sabas1080/Moonmakers_Cerebro/www/DIY EEG_files/FLZT2TPH3Z3C82W.LARGE.jpg

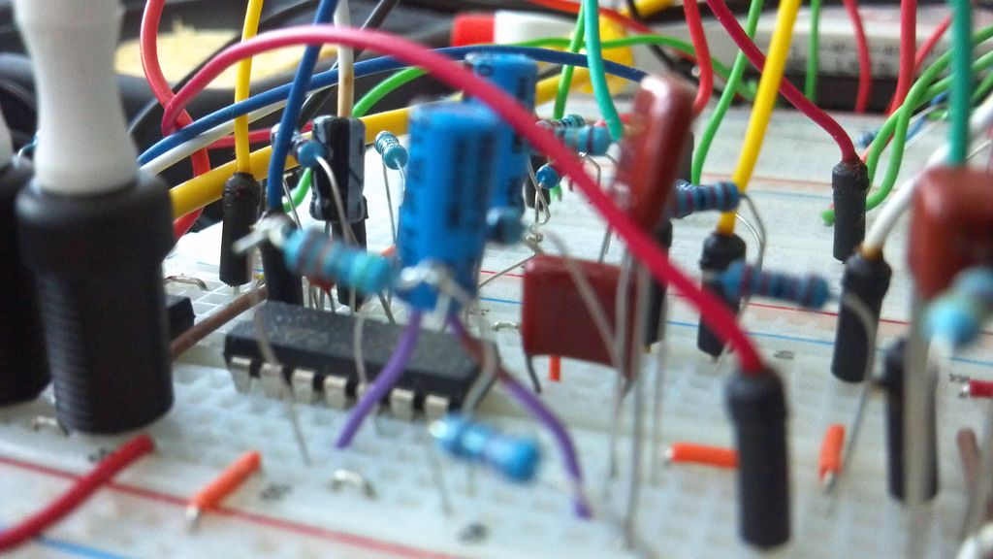
www/DIY EEG_files/FLZT2TPH3Z3C82W.LARGE.jpg
