sabas1080/Moonmakers_Cerebro/www/DIY EEG_files/FRONM3BH3QF1F05.LARGE.jpg

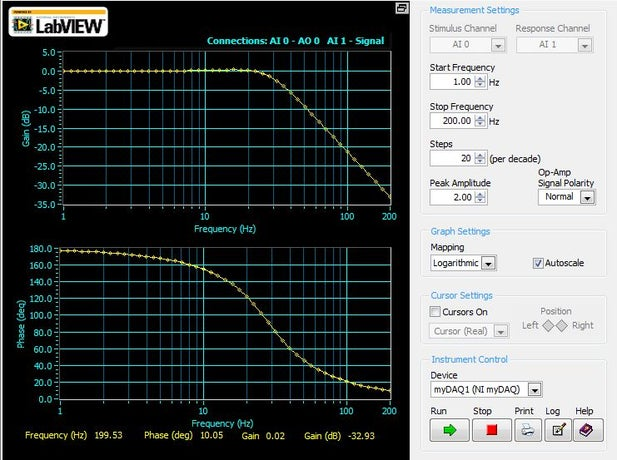
www/DIY EEG_files/FRONM3BH3QF1F05.LARGE.jpg
