sabas1080/Moonmakers_Cerebro/Docs/EEG/A5.pdf

## 4. Diseño y Construcción del EEG

### Juan Alejandro Alonso Toledo Herson Daniel Diaz Luna José Roberto Mendoza Pastor

13

### 4 DISEÑO Y CONSTRUCCIÓN DEL EEG

## 4. Diseño y Construcción del EEG

### Juan Alejandro Alonso Toledo Herson Daniel Diaz Luna José Roberto Mendoza Pastor

14

### 4.1 Etapa de amplificación

En general las señales generadas por el cuerpo humano tienen amplitudes muy pequeñas, comprendidas entre 1μV y 100 mV, aunado a ello existen grandes niveles de interferencia y ruido asociado a las mismas. Estas señales requieren ser amplificadas para hacerlas compatibles con una variedad de dispositivos, como equipos de cómputo, display y convertidores A/D, y de esta manera también se pueden manipular y trabajar a nuestra conveniencia, en este caso, un electroencefalógrafo. Para ello existen algunas recomendaciones que se deben tener en cuenta:

✓ El proceso fisiológico que será monitorizado no debe ser modificado de ninguna forma alguna por el amplificador.

✓ La señal medida no debe estar distorsionada.

✓ El amplificador debe ofrecer una señal de salida limpia, es decir sin interferencias.

✓ El amplificador debe ofrecer protección al paciente de cualquier shock eléctrico.

✓ El amplificador debe tener una protección contra daños causados por altos voltajes de entrada, ya que estos están presentes durante el uso de desfibriladores o algún otro elemento como un mal diseño de la instalación eléctrica, que no sea de grado médico o un mal sistema de tierras, es decir, que su impedancia esté por arriba de los 10 ohms.

El amplificador más recomendable para este fin es el amplificador de instrumentación debido a que cumple con todas las especificaciones ya comentadas.

## 4. Diseño y Construcción del EEG

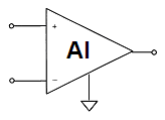
[picture p3: figure]

### Juan Alejandro Alonso Toledo Herson Daniel Diaz Luna José Roberto Mendoza Pastor

15

El amplificador de instrumentación ofrece el comportamiento más cercano a un amplificador ideal, la siguiente imagen muestra el símbolo del Amplificador de instrumentación (AI).

Fig. 4. Amplificador de instrumentación.

Los amplificadores de Instrumentación son amplificadores diferenciales que cumplen unos requisitos generales:

- Ganancia: seleccionable, estable, lineal.
- Entrada diferencial: con Razón de Rechazo en Modo Común (CMRR) alta.
- Error despreciable debido a las corrientes y tensiones de offset.
- Impedancia de entrada alta.
- Impedancia de salida baja

El circuito INA129 es el que mejor se adecua a nuestras necesidades ya que cuenta con un offset bajo, una corriente de bias mínima.

El circuito INA129 nos permite ajustar la amplificación a nuestra conveniencia simplemente modificando el valor de una resistencia llamada RG como se muestra en la figura 5, de tal modo que no es necesario calibrar resistencias:

## 4. Diseño y Construcción del EEG

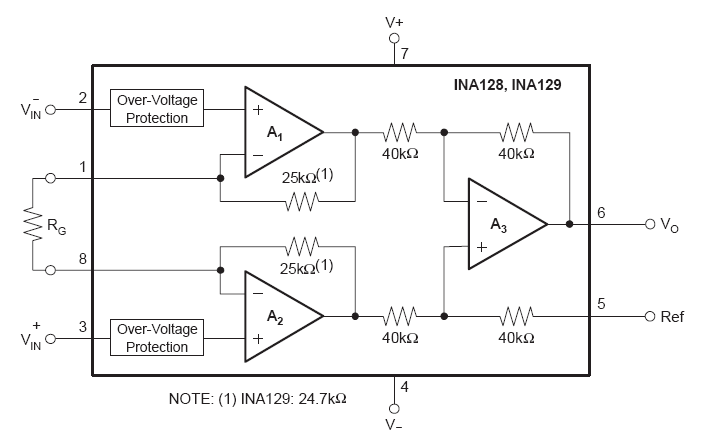
[picture p4: figure]

### Juan Alejandro Alonso Toledo Herson Daniel Diaz Luna José Roberto Mendoza Pastor

16

Fig. 5 INA129

En el diagrama se puede apreciar que el circuito integrado (CI) ya tiene un módulo de protección para sobre voltaje, antes de la amplificación.

Observar que RG permite variar la ganancia sin afectar la razón de rechazo en modo común, detallando que las resistencias ya están calibradas y nuestros acoplamientos establecidos por el INA129, la ganancia se obtiene con la siguiente expresión:

## 4. Diseño y Construcción del EEG

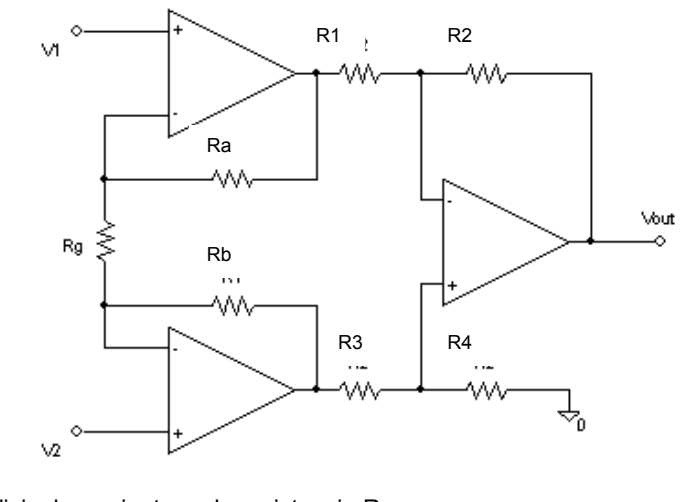
[picture p5: figure]
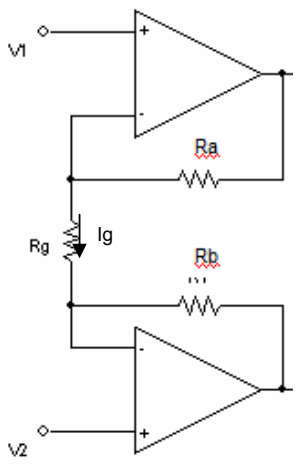
[picture p6: figure]

### Juan Alejandro Alonso Toledo Herson Daniel Diaz Luna José Roberto Mendoza Pastor

17

Análisis matemático.

Amplificador de Instrumentación: INA129

Se realiza el análisis de corriente en la resistencia Rg.

Vo

Rg

V V

Ig | 1 - 2 = | ;

### Ra Rg Rb

### Va Vb Ig

+ +

- =

Vb

Va

## 4. Diseño y Construcción del EEG

### Juan Alejandro Alonso Toledo Herson Daniel Diaz Luna José Roberto Mendoza Pastor

18

Para cumplir con una alta Razón de Rechazo en Modo Común, hacemos que Ra=Rb=R, entonces se igualan las ecuaciones.

Rg

### V1 -V2 = R Rb Va Vb

+

2
( | ) Rg V V
Vo Va Vb | R Rg 1 | 2 2 | - = | - | = | +
( | ) 1 | 2
2 1 | V V
Rg
R Vo | - ÷
÷
ø

ö
ç

ç
è

æ = +

Etapa diferencial

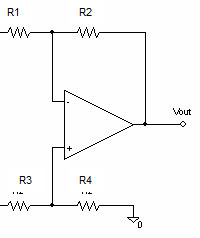
[picture p7: figure]

Obtenemos Vout, aplicando los valores al amplificador diferencial.

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
Vout
+

+
= - +

Esta es la expresión general. Para una condición ideal en la que R1=R3 y R2=R4, se tiene:

### ( ) Va Vb

R

R
Vout = - | -

1

2

## 4. Diseño y Construcción del EEG

### Juan Alejandro Alonso Toledo Herson Daniel Diaz Luna José Roberto Mendoza Pastor

19

Cómo Vo=Va-Vb, entonces, el caso general:

( | ) 1 | 2

1

2 1 2 V V
Rg

R
R

R
Vout | - ÷

÷
ø

ö
ç

ç
è

æ = - +

La ganancia:

÷

÷
ø

ö
ç

ç
è

æ = +
Rg

R
R

R
G 1 2

1

2

Para calcular el CMRR se sabe que:

CMRR=

### Gcm

Gd

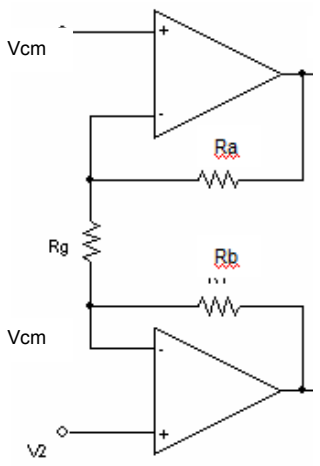
[picture p8: figure]
Vcm

Se deduce que la tensión en V1 y V2 es la misma por lo que:

CMRR= | 1 | 2

2

1 | 2 | * . . | Gd CMR

### Gcm

### Gd x Gd Gcm

Gd = | =

## 4. Diseño y Construcción del EEG

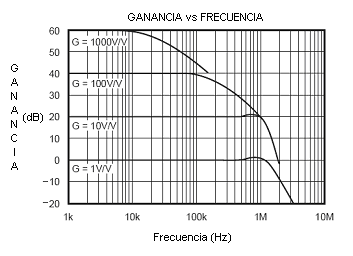
[picture p9: figure]

### Juan Alejandro Alonso Toledo Herson Daniel Diaz Luna José Roberto Mendoza Pastor

20

La etapa de amplificación está basada como anteriormente se mencionó en el circuito integrado INA129, ya que éste solo nos provee de una ganancia máxima igual a 1,000 se manejarán tres etapas adicionales de amplificación, las cuales serán amplificadores inversores, cabe señalar que estos amplificadores serán TL062, para lograr una ganancia igual a 1,000,000 con la finalidad de ver las señales neuronales en una escala de 0 a 0.5 volts, y así mismo esto servirá para poder realizar la comunicación con la computadora, ya que el muestreo de las señales tiene que estar en el orden de los volts para poder ser monitorizados y muestreadas por la computadora; de tal forma que las ganancias de las etapas quedarán de la siguiente manera:

- Amplificador de instrumentación: Para este amplificador se manejará una ganancia de 100, para que este no trabaje a su máxima potencia y vaya a introducir ruido en la señal a causa de la frecuencia que se maneja.

Fig. 6 Comportamiento del INA129

## 4. Diseño y Construcción del EEG

### Juan Alejandro Alonso Toledo Herson Daniel Diaz Luna José Roberto Mendoza Pastor

21

Se calculó con la siguiente expresión:

100 = 1+

Por lo tanto el valor de la resistencia | para el primer amplificador es de RG=
498.98Ω
- Post amplificadores inversores: En esta etapa se manejarán dos ganancias una de 100 para la segunda etapa y otra de 10 para la tercera y cuarta etapas, la finalidad de agregar una cuarta etapa es que la señal no quede invertida y se calculó de la siguiente manera:

Vout = - Vin

- Así que para la segunda etapa, con ganancia de 100, se utilizaron resistencias Rf=10 kΩ y Rin=100 Ω, lo que brinda una ganancia de 100.
- Y finalmente para la tercera y cuarta etapa, la ganancia de 10, se utilizaron resistencias Rf=1 kΩ y Rin=100 Ω, lo que nos brinda una ganancia de 10.

Ya teniendo las ganancias se realiza el cálculo de la ganancia total que es 100x100x10x10= 1,000,000.

49.4KΩ
RG

G = 1+

49.4KΩ
RG

RG = 49.4KΩ
99

Rf
Rin

## 4. Diseño y Construcción del EEG

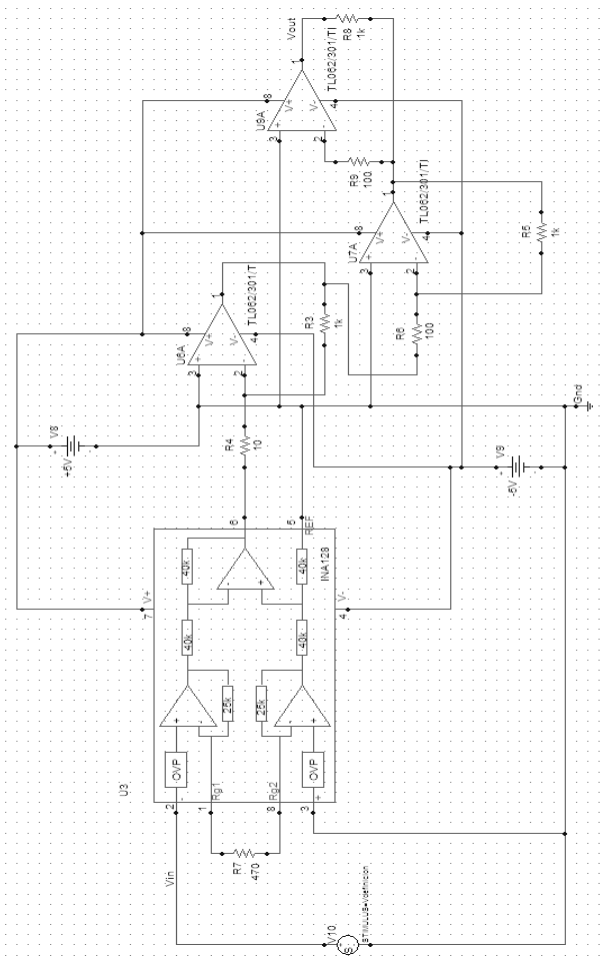
[picture p10: figure]

### Juan Alejandro Alonso Toledo Herson Daniel Diaz Luna José Roberto Mendoza Pastor

22

## 4. Diseño y Construcción del EEG

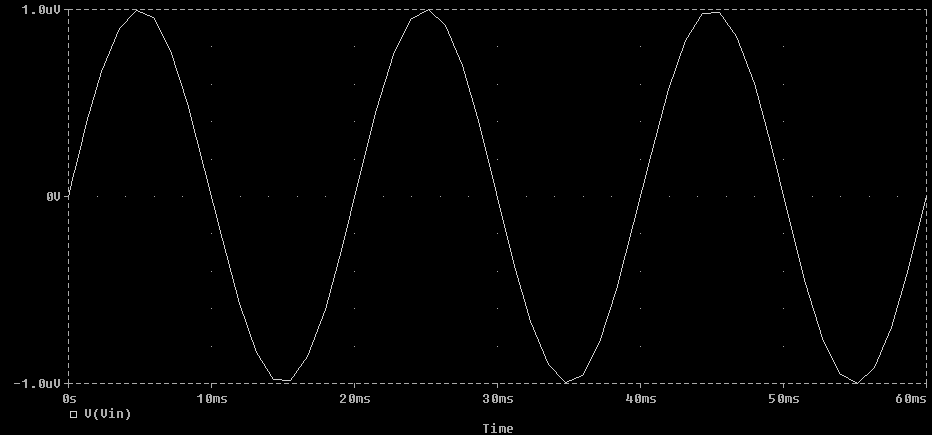
[picture p11: figure]
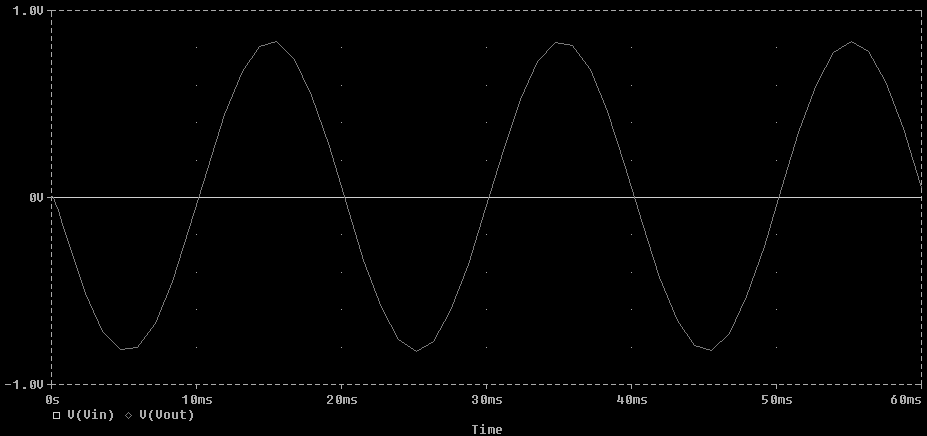
[picture p12: figure]

### Juan Alejandro Alonso Toledo Herson Daniel Diaz Luna José Roberto Mendoza Pastor

23

Fig. 7 Diseño de la etapa de amplificación Una vez calculado, la simulación arroja lo siguiente:

Simulación

Fig. 8 Señal de entrada (Vin) = 2μVPP@50Hz

Fig. 9 Señal de salida (Vout) ≈1.6VPP@50Hz

## 4. Diseño y Construcción del EEG

### Juan Alejandro Alonso Toledo Herson Daniel Diaz Luna José Roberto Mendoza Pastor

24

### 4.2 Etapa de filtrado

Los filtros son de los elementos más utilizados en equipos eléctricos. Su función es separar y dejar pasar las señales presentes en ciertas bandas de frecuencia y bloquear las señales de otras bandas que no sean deseables. En general en un filtro eléctrico deben pasar, sin perdidas, la energía en algunas frecuencias e introducir atenuación en otras.

Los electroencefalógrafos empleados en las clínicas y hospitales, se diseñan dentro de las frecuencias de importancia clínica, comprendidas entre los 0.1 y los 50 Hz; por lo tanto, para el modelo clínico, la frecuencia superior deberá estar limitada mediante un filtro pasa bajas, con una frecuencia de corte en los 50 Hz, sin embargo el diseño cuenta con una frecuencia de corte de 120 Hz para permitir a los neurólogos el estudio de la banda gamma. Para esto se utiliza el apoyo del amplificador, el cual proporciona impedancia de entrada alta por lo tanto corriente de entrada baja e impedancia de salida baja.

Para esta aplicación se han elegido filtros activos, ya que los filtros pasivos RLC presentan grandes inconvenientes prácticos para las bajas frecuencias. Esto se debe a que cuanto más baja es la frecuencia, más grandes, y deficientes son los inductores.

Otras ventajas de los filtros activos son:

1. Tamaño reducido.- Debido al empleo de Amplificadores Operacionales (AO) integrados, se reducen las dimensiones del circuito, siendo los capacitores (de mayor tamaño a menor frecuencia) los que generalmente fijan el tamaño del dispositivo.
2. Independencia entre etapas.- Permite la realización de filtros de cualquier orden, simplemente conectando en cascada etapas de primer y segundo orden; además cada etapa puede ser ajustada por separado.
3. Ganancia en la banda de paso.- Además de proveer rechazo para las frecuencias, no deseadas, amplifica las señales cuya frecuencia se encuentra en la banda de paso del filtro.
4. Costo reducido.- El costo del filtro lo determina el amplificador operacional.

## 4. Diseño y Construcción del EEG

### Juan Alejandro Alonso Toledo Herson Daniel Diaz Luna José Roberto Mendoza Pastor

25

En el manejo de señales electroencefalográficas se tienen señales no periódicas y que hacen irreconocible la señal que verdaderamente se quiere estudiar, a esto se le conoce como ruido. Al amplificar es posible que se magnifiquen las señales biológicas a medida que se aumenta la amplificación. Esto quiere decir que al utilizar una máxima amplificación, señales demasiado pequeñas podrían ser detectadas. Cuando la señal biológica se encuentra en el nivel de una señal ruidosa o en el mismo nivel, ambas señales serán amplificadas por igual, perdiéndose el valor de la señal de interés. El nivel de ruido en la electroencefalografía, es un potencial generado por los amplificadores y también puede ser externo, y no debe exceder de 2µV; este potencial se origina en la primera etapa de amplificación.

En el tratamiento de señales se debe tomar en cuenta que existen algunas frecuencias que no son deseadas. Se requiere eliminar señales que tengan valores de frecuencia que pudieran interferir y obstruir la exacta observación de las señales electroencefalográficas. Para éste propósito después de la etapa de amplificación utilizamos una etapa de filtrado en la que se empleó un filtro paso bajas y un filtro supresor de banda, esto por las características de las señales a tratar.

## 4. Diseño y Construcción del EEG

### Juan Alejandro Alonso Toledo Herson Daniel Diaz Luna José Roberto Mendoza Pastor

26

Filtro paso bajas
Amplitud
Banda | Banda de
de paso | rechazo
fc | frecuencia

La respuesta en amplitud es
÷
ø

ö ç
è
æ = | Vi
Vo f dB | 10 ( ) 20log

Filtro Notch
A

Banda de
rechazo

f
fL | fo | fH

fo en función de Q, y la ganancia de banda de paso Ao, la respuesta del filtro notch en amplitud dB:

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
2 2 2

2

10
1

1

### ( ) 20log

### Qfo

### fin

fo

### fin

fo

### fin

### AdB Ao dB

Donde

2

L | H f | f fo | + = | ; | 2
4 ² | 2 BW | BW | fo f L
- | + | + = | ; f H = f L + BW

L H fo = f f , este ofrece un mejor promedio geométrico.

## 4. Diseño y Construcción del EEG

### Juan Alejandro Alonso Toledo Herson Daniel Diaz Luna José Roberto Mendoza Pastor

27

BW

fo Q = | ; | H | L BW = f - f

Por tanto:

| | H | L L H
H | L | f | f

f f
f | f
fo Q | - = - =

Filtro Butterworth

La respuesta en frecuencia generalmente:

n

PB

fc

### fin

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
= | ó
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
æ = | - | +

n

PB | fc

### fin AdB A dB

2

### ( ) 10log10 1

fin – frecuencia de entrada fc - frecuencia de corte
APB - ganancia de voltaje
n - orden del filtro

Filtros de 2º orden.

Función de transferencia:

2 1 1 2

( ) ( )

### a s a s

### P s H s

+ + =

P(s) depende del tipo de respuesta.

2

1 2
o

a

ω = ;
o

a
ω

2ζ 1 =

Factor de calidad:

2ζ

1 Q = | ; por tanto | Q o
a
ω

1 1 =

## 4. Diseño y Construcción del EEG

### Juan Alejandro Alonso Toledo Herson Daniel Diaz Luna José Roberto Mendoza Pastor

28

Para un filtro paso bajas:

2 | 2

2
( )
s o
Q

o
s

### o H s

ω

ω

ω
+ +

=

Tomamos en cuenta que utiliza la estructura:

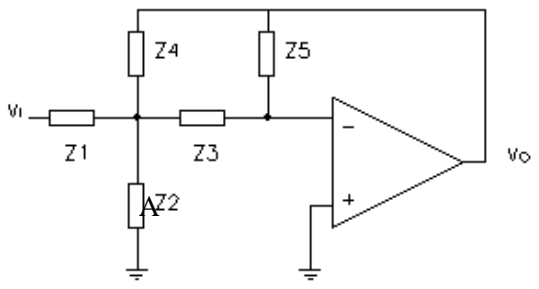
[picture p13: figure]

Analizamos V’ en el punto A:

5 Vo = IZ ;
Z5

### Vo I =

5

3
3 ' | Z

Z

### V = -IZ = -Vo

Aplicamos Kirchhoff en el Punto A:

0 ' 0 | ' | '
1 | 2 | 4 | 5
+ | = - + - + -
Z

Vo
Z

### Vo V

Z

V
Z

### Vi V

Despejamos Vi

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
+ | + | + ÷

÷
ø

ö
ç

ç
è
æ = - | +
1 | 4 | 5 | 1 | 2 | 4
1 | 1 | 1 ' 1 | 1
Z | Z | Z

V
Z Z

Vo
Z

Vi

## 4. Diseño y Construcción del EEG

### Juan Alejandro Alonso Toledo Herson Daniel Diaz Luna José Roberto Mendoza Pastor

29

Usando V’

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
æ = - | + | + | + | + | + ÷
÷
ø

ö
ç

ç
è
æ - | + | + ÷
÷
ø

ö
ç

ç
è
æ = - | +
5 | 1 | 2 | 4

3

5 | 1 | 2 | 4 | 4 | 5

3

1 | 4 | 5
1 | 1 | 1 | 1 | 1 | 1 | 1 | 1 | 1 | 1
Z | Z | Z | Z

Z
| | | | | Z | Z

Vo
Z Z | Z | Z

Z
Vo
Z Z

Vo
Z

Vi

Así la función de transferencia:

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
+ | + | + | + | +

= -

5 | 1 | 2 | 4

3

4 5

1
1 | 1 | 1 | 1 | 1

1

Z | Z | Z | Z

Z
Z Z

Z
Vi

Vo

Haciendo Z1, Z4 y Z3 resistencias y Z2, Z5 capacitores:

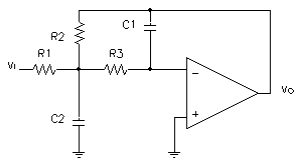
[picture p14: figure]

Tomando en cuenta que

2

2

1
sC

Z = y

5

5

1
sC

Z =

( | ) 1 2 3 2
2
3 1
1

2 3 1
2 1

1

2

2

2
1
1 | 3 | 1
2

1
1 1 | 1 | 1

1

### R C s C C R R

R

### R R C s R C

R

R

R

sC
R

### sC R sC

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
+ | + | +

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
+ | + | + | +

= -

Para una ganancia unitaria R2=R1:

( | ) | 3 2 1 2
2
1 | 2 | 3 1 | 2

1
Vi | sC R | R | s R R C C

Vo
+ | + | + = -
Cómo | 1 2

2
2

### 1 R C C

o = ω
si hacemos C1=C2

## 4. Diseño y Construcción del EEG

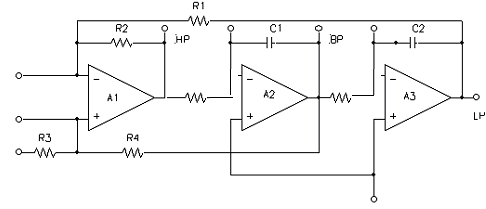
[picture p15: figure]

### Juan Alejandro Alonso Toledo Herson Daniel Diaz Luna José Roberto Mendoza Pastor

30

2 2
2

### 1 R Co

o = ω

### ; Obteniendo R

Co

R
ω

1 =

Filtro Universal
Al conectar 3 amplificadores Operacionales, se puede tener un paso bajas de orden 2, paso altas y paso banda, con gran factor de calidad Q.

A1 es un Amplificador diferencial, A2 y A3 integradores.

En la etapa de filtrado se empleo el circuito integrado UAF42 de Texas Instruments, un filtro universal activo que dentro de las ventajas que brinda es que puede ser configurado de distintas formas para poder convertirlo en un filtro paso bajas, paso altas y paso bandas. Su configuración se basa en un amplificador inversor y dos integradores. En este circuito los integradores incluyen capacitores de 1000pF. Este tipo de arquitectura resuelve un problema que se presenta al diseñar filtros activos, que es obtener una tolerancia ajustada, y tener capacitores de baja pérdida.

Para este circuito

### RC fc 2π

1 = | ; | 3 RA = (3Q -1)R

Este filtro permite valores de Q muy altos, con buena estabilidad.

## 4. Diseño y Construcción del EEG

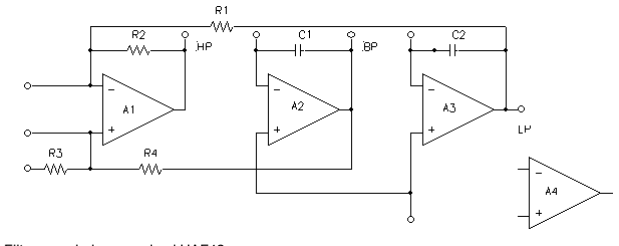
[picture p16: figure]
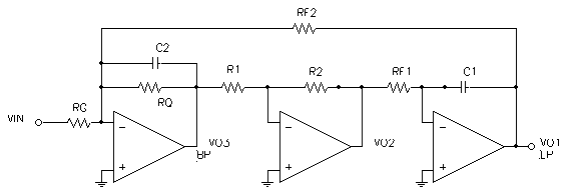
[picture p17: figure]

### Juan Alejandro Alonso Toledo Herson Daniel Diaz Luna José Roberto Mendoza Pastor

31

Filtro Universal: UAF42

Filtro paso bajas usando el UAF42

1 1

2
1 | sRF C
Vo Vo = - | ;

1 1

2

### 2 sRF C

R
Vo = -

1 1 1

2

### 1 3 sRF R C R Vo = Vo

Vo3 depende de las entradas, por tanto:

## 4. Diseño y Construcción del EEG

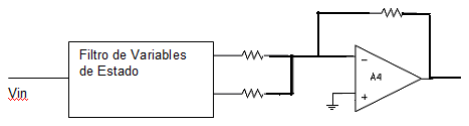
[picture p18: figure]

### Juan Alejandro Alonso Toledo Herson Daniel Diaz Luna José Roberto Mendoza Pastor

32

( | ) | ( | ) 1

1
| 1

1

1

1

1

1

2 | 2 | 2 | 2

2

2

2

2

3

+ - + = -

+

+
= - | RF sC RQ

### RQ Vo RG sC RQ

### RQ Vi

RF

### sC RQ

### sC RQ

Vo
RG

### sC RQ

### sC RQ

### Vo Vi

Sustituyendo Vo1:

( | ) 1 | ( | ) 1 1 1 1 | 2 | 2

2
3
2

3

+ - + = - | RF sC RQ

RQ

### sRF R C

R
Vo

### RG sC RQ

RQ Vo | Vi
( | ) 1 | ( | ) 1

1

2 | 2 | 1 1 1 | 2

2
3

+ ú = -
û

ù ê
ë

é
+

+

### RG sC RQ

### RQ Vi RF sC RQ sRF R C

### RQR Vo

La función de transferencia es:

( | )
( | ) | 1 | 2 1 1
| | | 2
2
2 | 1 | 2 1 1

2

3 | 2
1
1

1

1

### sRF RF C R

### RQR sC RQ

RG

RQ

sC RQ | sRF RF R C RQR
RG | sC RQ RQ

Vi

Vo
+ +

= -
+

+

+ = -

1 | 2 1 2 1
| 2

2

2

3 | 2

### RF RF C C R

R

### C RQ

S
s

### RGC

s

Vi

Vo
+ +

= -

Una característica del filtro universal es que se puede sumar el paso bajas y el paso altas, lo que nos da un filtro Notch de variables de estado. Para esto se requiere un amplificador Operacional adicional y 3 resistencias iguales.

Notch Out

## 4. Diseño y Construcción del EEG

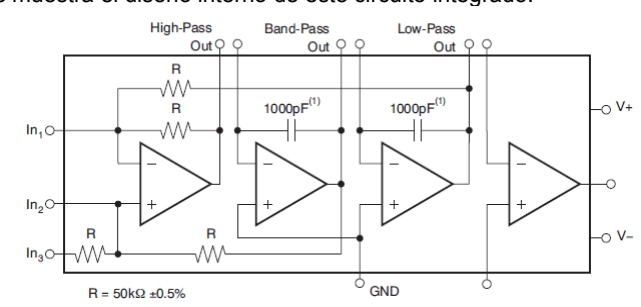
[picture p19: figure]

### Juan Alejandro Alonso Toledo Herson Daniel Diaz Luna José Roberto Mendoza Pastor

33

A continuación se muestra el diseño interno de este circuito integrado:

Fig. 10 Diseño interno del UAF42

La topología clásica de este circuito forma un filtro de tiempo continuo. Libre de anomalías y ruido conmutado asociado a filtros con capacitores conmutados.

Diseño de la etapa de filtrado

Para poder obtener una configuración exacta y con los valores precisos se utilizó un software compatible con DOS (sistemas operativos de disco), este software mediante los valores deseados de frecuencia que se quiere obtener y la tolerancia requerida brinda la configuración y los valores exactos de resistencias y capacitores externos para poder generar los filtros utilizados.

El software utilizado, proviene de una serie de programas de diseño llamado FilterPro creados por Burr-Brown. Utilizando el llamado FILTER42, que es específicamente usado para configuraciones del UAF42. El programa es sencillo, es una guía paso a paso y realiza el cálculo exacto de los valores de los componentes. Para un filtro Butterworth, se tiene una atenuación de 3dB en la frecuencia de corte. El circuito más simple consiste en un solo subcircuito de dos polos como se muestra en la figura

Fig. 11 Subcircuito 1

## 4. Diseño y Construcción del EEG

### Juan Alejandro Alonso Toledo Herson Daniel Diaz Luna José Roberto Mendoza Pastor

34

Otros filtros más complejos son armados en cascada. Incluso filtros de otros órdenes son implementados completamente con secciones de dos polos con el UAF42 y no se requieren capacitares externos.

Fig. 12 Filtros en cascada

En este caso la etapa de filtrado se arma en cascada, primero la señal pasa por el filtro pasa bajas y después por el filtro de rechazo de banda mediante herramientas que se muestran más adelante.

Por las características mencionadas antes, se utilizó un filtro Butterworth que entrega mejores resultados que las otras familias, maximiza la magnitud de aplanamiento en la respuesta en un paso banda, un buen comportamiento completo, una respuesta de pulso mejor que el Chebyshev y una razón de atenuación mejor que el Bessel.

El programa provee subcircuitos de par-polo, estos consisten en una configuración de estado variable. Dos parámetros deben ser configurados para el par-polo son el filtro Q y la frecuencia natural fo. Para esto se tienen dos resistencias, Rf1 y Rf2 para configurar fo. Y una resistencia externa RQ es usualmente utilizada para configurar Q.

## 4. Diseño y Construcción del EEG

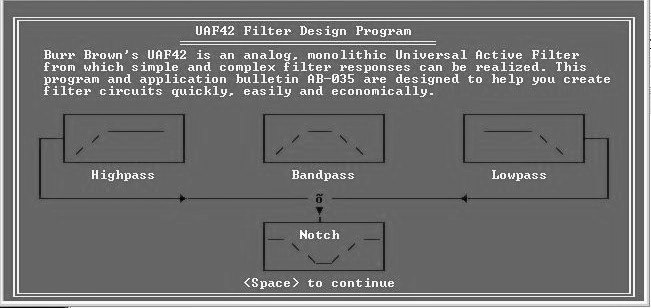
[picture p20: figure]
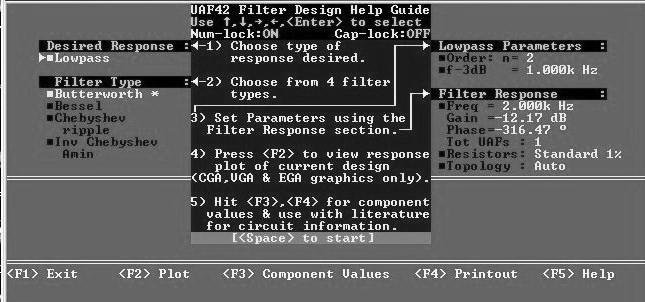
[picture p21: figure]

### Juan Alejandro Alonso Toledo Herson Daniel Diaz Luna José Roberto Mendoza Pastor

35

El programa:

Fig. 13 Pantalla inicial del programa

En la ventana se muestra el tipo de filtros que puede diseñar el programa, a continuación para poder entrar al menú de configuración, el cual nos presenta una pequeña guía.

Fig. 14 Menú del programa

El menú Desire Response. Permite elegir entre cuatro tipo de filtros: Paso bajas, paso altas, paso banda y rechazo de banda.

El menú Filter Type. Nos da a elegir entre varios grupos de filtros.

## 4. Diseño y Construcción del EEG

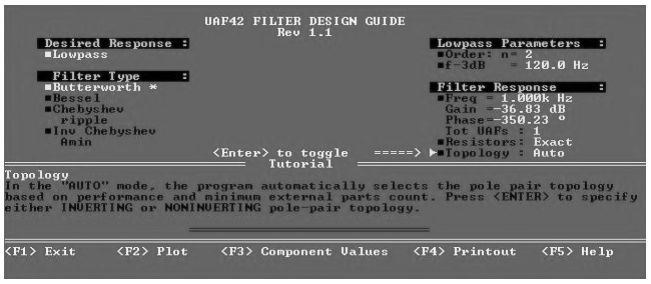
[picture p22: figure]
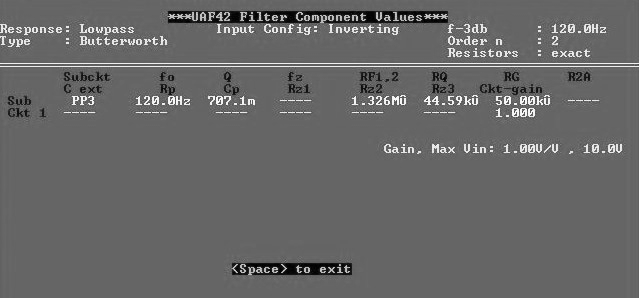
[picture p23: figure]

### Juan Alejandro Alonso Toledo Herson Daniel Diaz Luna José Roberto Mendoza Pastor

36

El menú Parameters. Esta sección permite configurar los parámetros de orden del filtro n (de 2 a 10), y la frecuencia del filtro.

El menú Filter Response. Para poder configurar la respuesta en frecuencia.
En este caso se eligió un filtro paso bajas tipo Butterworth, y se configuran los valores de frecuencia y respuesta deseados.

Fig. 15 Elección de la topología La topología a utilizar se obtiene automáticamente mediante el programa y se busca en la hoja de especificaciones, son los llamados par-polo (PP). En la parte inferior muestra un menú, ahora se elige la opción Component Values, para obtener los valores exactos.

Fig. 16 Valores de los componentes a usar

## 4. Diseño y Construcción del EEG

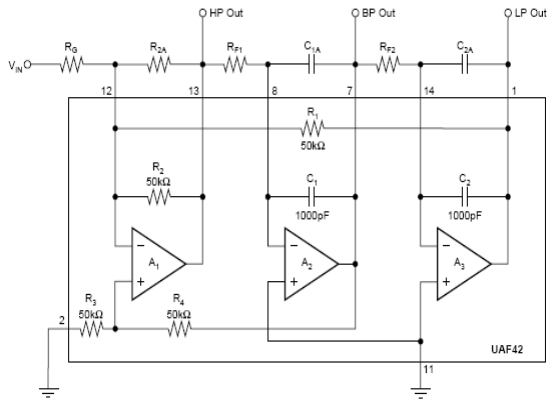
[picture p24: figure]

### Juan Alejandro Alonso Toledo Herson Daniel Diaz Luna José Roberto Mendoza Pastor

37

La ventana muestra una serie de valores de frecuencia natural (fo) en este caso de 120 Hz, los valores de RF1 y RF2, así como de RQ y Rg, los cuales proporcionan una ganancia unitaria. También indica que PP utilizar para el filtro paso bajas y en este caso es el PP3 el cual se muestra a continuación.

Fig. 17 Configuración del filtro paso bajas

## 4. Diseño y Construcción del EEG

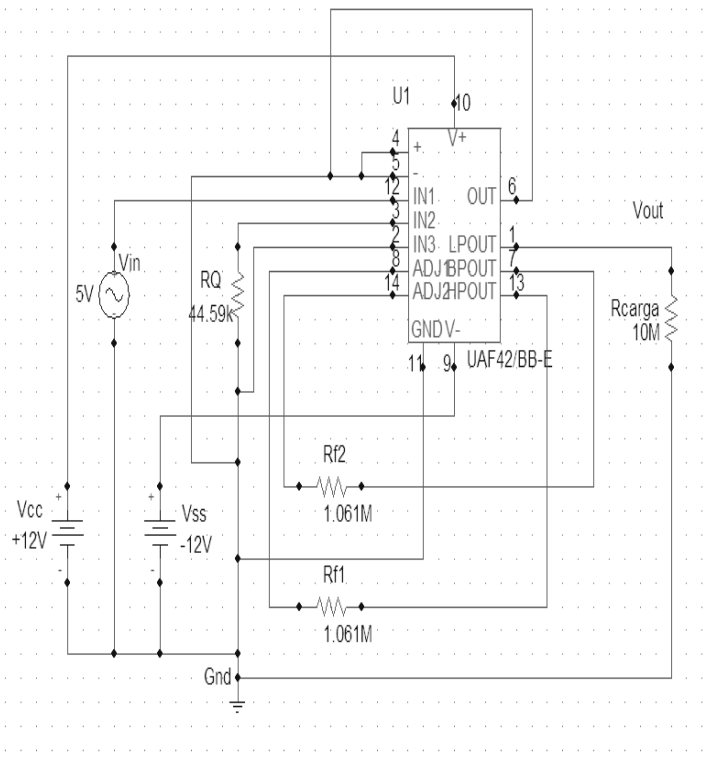
[picture p25: figure]

### Juan Alejandro Alonso Toledo Herson Daniel Diaz Luna José Roberto Mendoza Pastor

38

Fig. 18 El diseño utilizado para el filtro de paso bajas

## 4. Diseño y Construcción del EEG

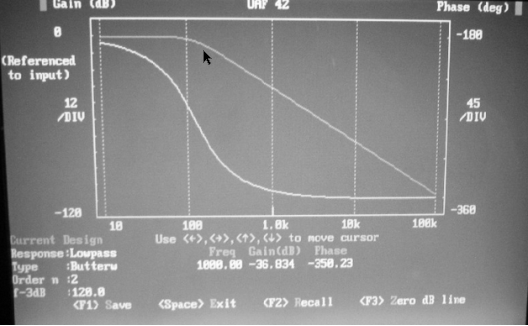
[picture p26: figure]

### Juan Alejandro Alonso Toledo Herson Daniel Diaz Luna José Roberto Mendoza Pastor

39

Mediante este software es posible visualizar una gráfica de fase contra frecuencia. Esto para comparar entre filtros y ver como se comportará en la implementación. Para este caso se observa así, donde la línea señalada por la flecha negra muestra el comportamiento del filtro.

Fig. 19 Gráfica del comportamiento del filtro

Para el filtro rechazo de banda se realiza lo mismo, solo que debemos elegir el filtro Notch. Configurar el orden, que en este caso es de 4º orden, la frecuencia de corte de 60Hz y un ancho de banda de 10 Hz. Como se muestra en la figura 20.

## 4. Diseño y Construcción del EEG

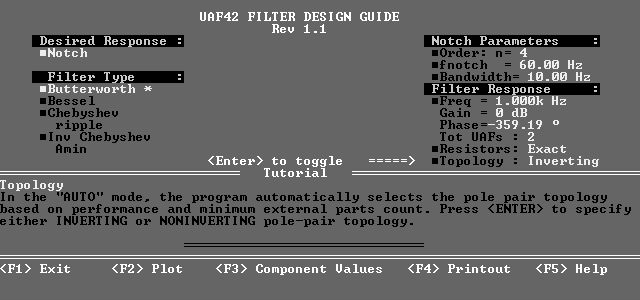
[picture p27: figure]
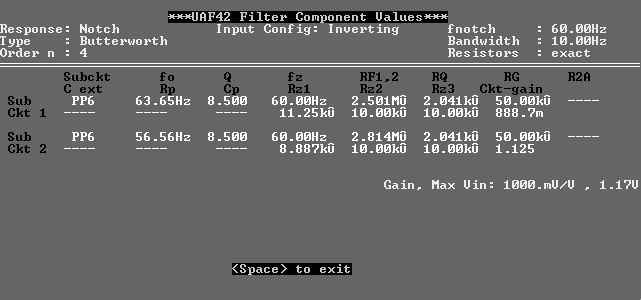
[picture p28: figure]

### Juan Alejandro Alonso Toledo Herson Daniel Diaz Luna José Roberto Mendoza Pastor

40

Fig. 20 Elección de la topología

El siguiente paso es conocer los valores y el tipo de topología a utilizar (PP). Mediante la opción Component Values.

Fig. 21 Valores de los componentes a usar

El cual proporciona una serie de valores para las resistencias y el subcircuito PP a utilizar, en este caso es el PP6, esta configuración suma las salidas de paso bajas y paso altas utilizando un amplificador operacional auxiliar A4 dentro del UAF42.

## 4. Diseño y Construcción del EEG

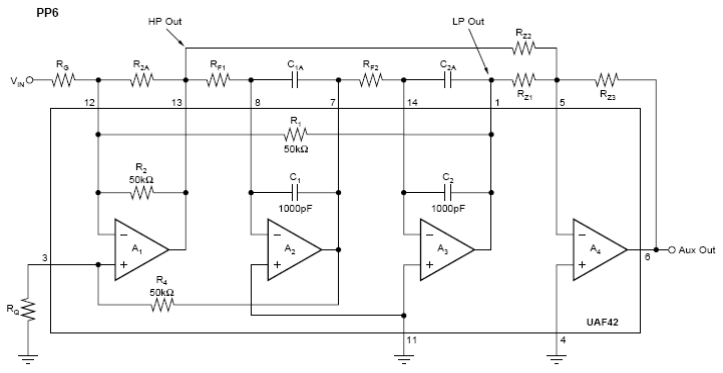
[picture p29: figure]
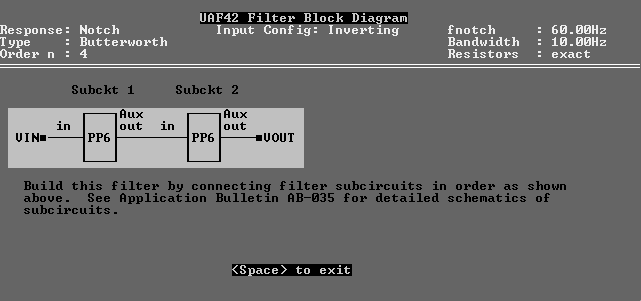
[picture p30: figure]

### Juan Alejandro Alonso Toledo Herson Daniel Diaz Luna José Roberto Mendoza Pastor

41

Fig. 22 Configuración del subcircuito para el filtro rechazo de banda.

Para lograr el filtro rechazo de banda, se requiere colocar dos subcircuitos PP6 en cascada como se muestra en la figura 23.

Fig. 23 Diagrama de bloques del filtro rechazo de banda.

Quedando el diseño del filtro supresor de banda de la siguiente manera, utilizando dos UAF42 conectados en cascada.

## 4. Diseño y Construcción del EEG

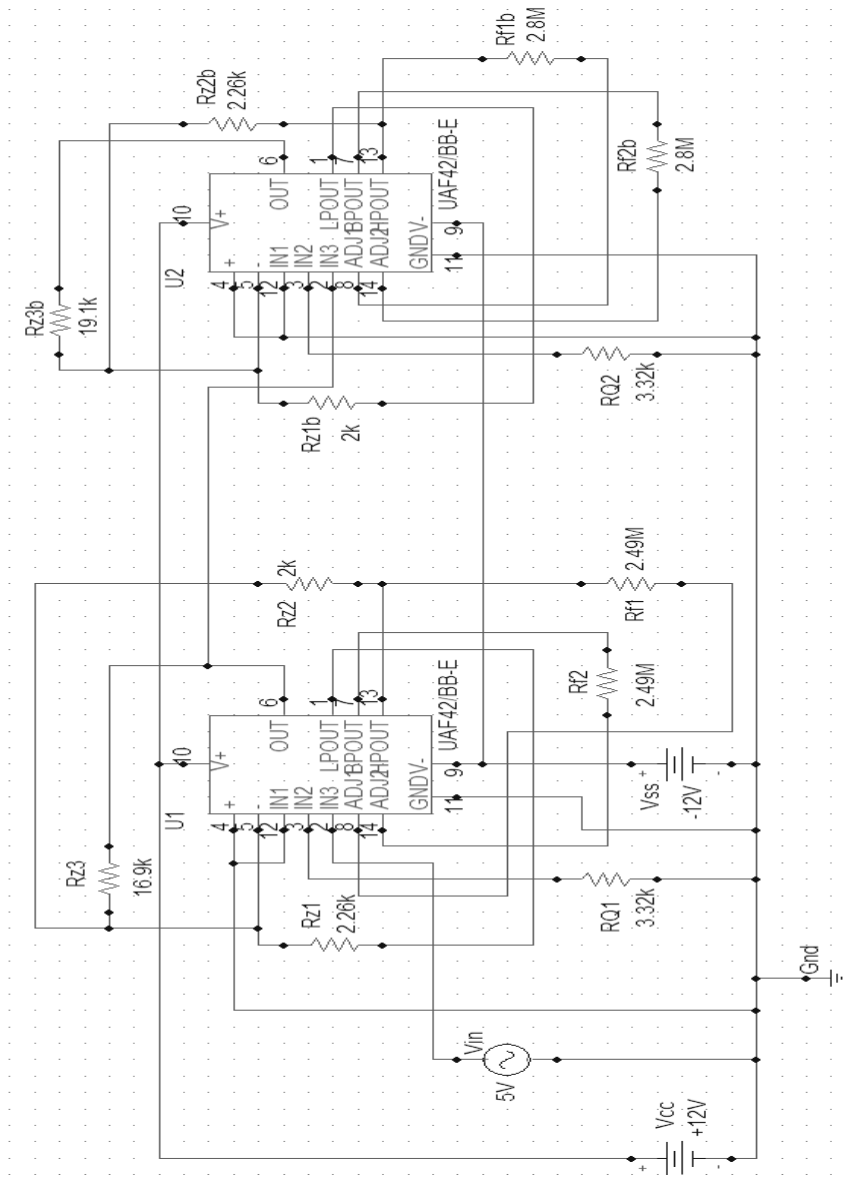
[picture p31: figure]

### Juan Alejandro Alonso Toledo Herson Daniel Diaz Luna José Roberto Mendoza Pastor

42

Fig. 24 Filtro rechazo de banda

## 4. Diseño y Construcción del EEG

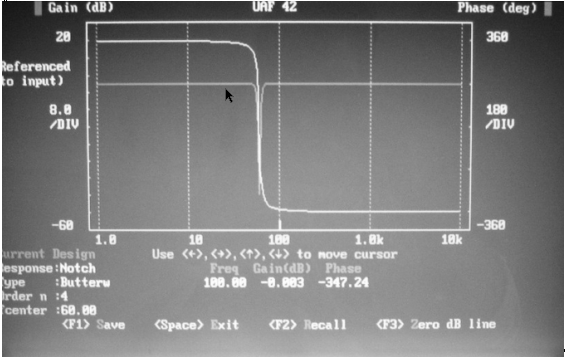
[picture p32: figure]

### Juan Alejandro Alonso Toledo Herson Daniel Diaz Luna José Roberto Mendoza Pastor

43

También usando la utilidad Plot se obtuvo la gráfica de cómo se comportará nuestro filtro rechazo de banda.

La línea señalada con la flecha negra indica el comportamiento del filtro el cual tiene su mayor atenuación al llegar a los 60Hz.

Fig. 25 Gráfica del comportamiento del filtro

## 4. Diseño y Construcción del EEG

### Juan Alejandro Alonso Toledo Herson Daniel Diaz Luna José Roberto Mendoza Pastor

44

### 4.3 Etapa de compensación de offset

En las aplicaciones de amplificadores de corriente continua, ciertas características eléctricas del amplificador operacional pueden provocar errores en el voltaje de salida, para ello es posible implementar un circuito divisor con resistencias aceptablemente complejo que pueda imprimir un pequeño voltaje variable para compensar los efectos de la desviación de voltaje en la entrada y la desviación de corriente. Sin embargo, los componentes extra son más costosos y grandes de lo necesario.

Generalmente uno de los principales problemas que se tiene en el registro de un EEG es el corrimiento de la línea de base producido por causas tan variadas como; movimientos involuntarios del paciente, polarización de los electrodos por un mal contacto, fluctuaciones de temperatura, etc.; lo que dificulta tener una buena calidad en la señal registrada, por lo que contar con un sistema de compensación de offset es sumamente necesario.

El efecto de la tensión de offset de entrada sólo es influida por la ganancia de la etapa, y esta es una característica funcional que está establecida en las especificaciones del diseño. Hay dos formas de atenuar el efecto del offset de tensión:

1. Seleccionando el amplificador operacional adecuado: Los fabricantes reducen el offset de tensión de entrada de los amplificadores operacionales utilizando técnicas especiales de diseño del amplificador. Actualmente se ofrecen amplificadores operacionales con offset muy bajos.
2. Compensando el offset mediante un circuito interno o externo: En aplicaciones de precisión, se debe compensar el efecto combinado del offset de tensión de entrada, de la intensidad de polarización y de la intensidad de offset.

Cuando un amplificador no posee un mecanismo de compensación de offset interno, se puede añadir algunos elementos externos que realicen su cancelación. En estos circuitos es muy importante tener en cuenta lo pequeño del valor del offset que se está compensando. Para este proyecto se utilizó un modelo de corrector de offset a la salida de la etapa de filtrado, con la finalidad de garantizar una señal limpia, libre de voltaje de offset, ya que debido a la naturaleza de

## 4. Diseño y Construcción del EEG

### Juan Alejandro Alonso Toledo Herson Daniel Diaz Luna José Roberto Mendoza Pastor

45

nuestra ganancia fácilmente es posible amplificar ruido de 60 Hz si no están bien calibradas nuestras etapas de filtrado.
Integrador (Compensador de Offset)

Vo

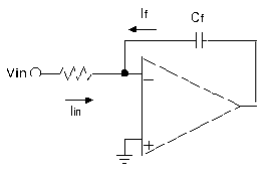
[picture p33: figure]

### Vin t

RC

## ΔVo = - • 1

R

Vin Iin = ;
t
Vo If | Cf Δ
Δ = - | ; | Vin t

### RCf

ΔVo = - | Δ 1
= | Þ
R

X
A | c
CL | ganancia de lazo cerrado ; | fRCf
ACl | 2π

1 =

En este caso se utilizó el TL062, utilizando la configuración de un amplificador integrador, en el cual se observó que el elemento que lleva a cabo la realimentación en el integrador es el condensador C1. Por consiguiente, la corriente constante I, en C1 da lugar a una rampa lineal de tensión. La tensión de salida es, por tanto, la integral de la corriente de entrada (que proviene de la salida de la etapa de filtrado), que es forzada a cargar C1 por el lazo de realimentación, obteniendo una señal de salida sin corrimiento, desviación de voltaje, la configuración se muestra en la siguiente imagen:

## 4. Diseño y Construcción del EEG

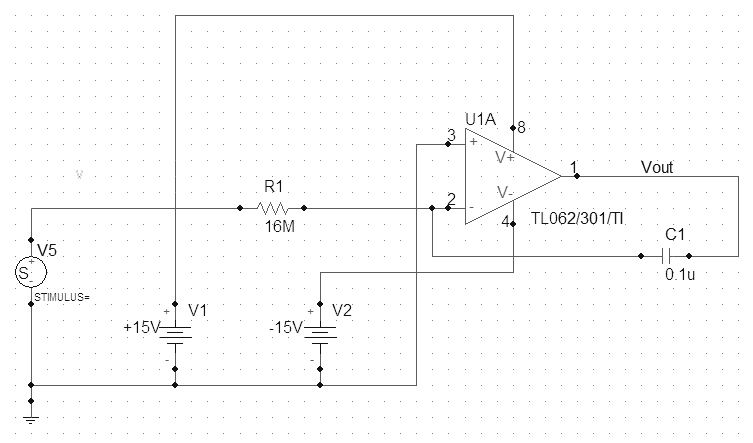
[picture p34: figure]

### Juan Alejandro Alonso Toledo Herson Daniel Diaz Luna José Roberto Mendoza Pastor

46

Fig. 26 Compensador de offset

Tomando como base un capacitor de 0.1μF y una frecuencia de trabajo de 0.01Hz se calculó la resistencia necesaria del modo siguiente:

f =

R =

R = | = 16MΩ

1
2пRC

f2пC

1

0.01(2п)0.1μ

1

## 4. Diseño y Construcción del EEG

### Juan Alejandro Alonso Toledo Herson Daniel Diaz Luna José Roberto Mendoza Pastor

47

Con esta última etapa termina el módulo del acondicionamiento de la señal, que es la parte elemental del diseño e implementación del electroencefalógrafo que se ha construido.

### 4.4 Etapa de aislamiento

Independientemente de lo simple o complejo que sea un dispositivo médico de medición, este debe ser seguro, la seguridad debe ser el primer objetivo del diseño. Cuando se habla de seguridad se refiere principalmente a la seguridad eléctrica, debido a que los daños que pueden ser causados al cuerpo humano son severos, por ejemplo se sabe que una corriente, de 60Hz, con una intensidad de 10μA que fluye a través del corazón causará un daño permanente al mismo o incluso la muerte. Por lo cual se deben tener en consideración las bases para diseñar y construir un sistema médico eléctricamente seguro.

Efectos de la corriente eléctrica en el cuerpo humano

Las corrientes eléctricas producen tres tipos de efectos en el cuerpo humano: alteraciones funcionales por estimulación de células excitables (tejidos nervioso y muscular); destrucción irreversible de tejidos por efecto Joule; y quemaduras químicas. Los dos primeros son los más graves generalmente y no dependen del origen de las corrientes. Las quemaduras químicas se producen al reaccionar con la piel los electrólitos liberados por el paso de una corriente continua o de muy baja frecuencia. Para evitarlas hay que limitar su valor a 10μA como máximo.
En los tejidos excitables se ha encontrado experimentalmente que hay una relación entre la intensidad y la duración de la corriente necesarias para que se produzca la estimulación, y que varía según los tejidos. Cuando se presentan estímulos cortos, hace falta más corriente, y por ello al aumentar la frecuencia es mayor la amplitud necesaria para lograr la estimulación. Las peores frecuencias resultan ser precisamente las de 50-60Hz. Por otra parte, por debajo de una intensidad mínima (denominada reobase) no hay estimulación aunque esté aplicada durante mucho tiempo. Por último, cabe destacar que el parámetro de interés no es la tensión sino la intensidad de corriente, aunque, como el área de contacto puede ser muy variable, los límites se dan como valores de intensidad de corriente.

El nivel mínimo en el que una persona puede detectar conscientemente si hay o no un estímulo presente (cosquilleo), define el umbral de percepción. Depende sobre todo de la zona del cuerpo y del área de contacto, del sexo y de la frecuencia. Por ejemplo, para frecuencias de 50-60Hz,

## 4. Diseño y Construcción del EEG

### Juan Alejandro Alonso Toledo Herson Daniel Diaz Luna José Roberto Mendoza Pastor

48

cuando un hombre se encuentra tocando un conductor con la mano, el valor medio es de 1.1mA. Si solo se apoya ligeramente el dedo, es de 0.36mA, mientras que deslizándolo es de 10μA. Con la lengua el valor mínimo es de 4μA y el valor medio 43μA. Para las mujeres, los valores al tocar o tocar con la mano son del 67% de los del hombre. A frecuencias menores y mayores, el umbral aumenta. El valor medio para hombres, tocando con la mano, es de 5.2mA en continua y de 12mA a 10kHz. Cuando el nivel de la corriente aumenta se alcanza un punto en el que la sensación es irritante si se va repitiendo.
Con niveles de corriente mayores se producen contracciones musculares involuntarias. Si el estímulo ocurre de forma inesperada, produce un reflejo muscular involuntario.

Para corrientes de 60Hz, el valor medio de la corriente necesaria en hombres es de 16mA. En si no es un peligro, pero, si se prolonga, puede producir asfixia. Para corrientes de 23mA, aparecen dificultades respiratorias en el 50% de los hombres.

La frecuencia de la corriente influye en los niveles necesarios para tener los efectos anteriores. En la siguiente figura se presentan las gráficas en función de la frecuencia. Para la corriente continua, la intensidad Ic.c. que produce el mismo efecto que una corriente alterna (50-60Hz) Ic.a., para tiempos entre 10ms y 10s, es:

I c.c = I c.c log t

Cuando la corriente es mayor, si el camino de la corriente incluye al corazón hay peligro de fibrilación auricular o ventricular, con la consiguiente pérdida de eficiencia en el bombeo de sangre. A diferencia de los efectos mencionados anteriormente, la fibrilación no desaparece al cesar el estímulo, y solo se puede detener mediante una descarga intensa. En el caso de un contacto directo con el miocardio, una intensidad de 100μA puede ser fatal.

Para corrientes mayores de 100mA se puede producir tetanización muscular (parálisis respiratoria si quedan afectados los músculos del tórax), y quemaduras externas si la intensidad de corriente es suficiente, con independencia de su frecuencia en este caso.

## 4. Diseño y Construcción del EEG

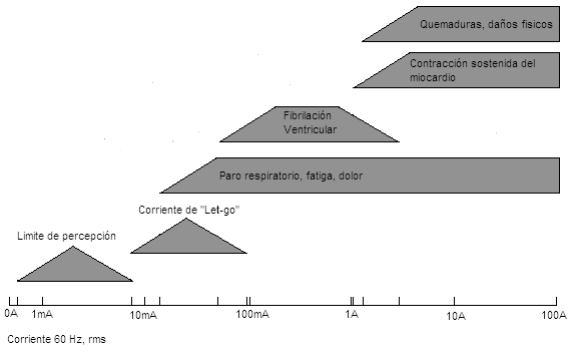
[picture p35: figure]

### Juan Alejandro Alonso Toledo Herson Daniel Diaz Luna José Roberto Mendoza Pastor

49

Fig. 27 Efectos de la corriente que fluye a través de un paciente.

También es importante para minimizar riesgos tomarse el tiempo necesario para instruir a los miembros del equipo clínico en el uso correcto del dispositivo y los posibles riesgos que pudieran existir en caso de negligencia o mal uso del mismo; recordar que si algo sale mal es el personal clínico quien deberá salvarle la vida al paciente.

### 4.5 Fuente de alimentación

Tomando en cuenta lo ya mencionado sobre seguridad del paciente una alternativa muy conveniente para alimentar los equipos médicos es el uso de baterías. Esto no solo asegura de manera inherente que las corrientes de fuga sean mínimas, también hace el equipo altamente portátil y permite tener un equipo muy seguro debido a que se asegura que el paciente y el equipo quedan totalmente aislados de la línea eléctrica sin importar que la instalación sea grado médico. Para este caso el uso de dos baterías recargables fue suficiente, lo que resulta muy conveniente ya que el costo es reducido aún teniendo que adquirir el cargador para dichas baterías.

## 4. Diseño y Construcción del EEG

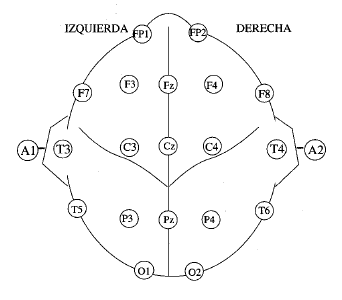
[picture p36: figure]

### Juan Alejandro Alonso Toledo Herson Daniel Diaz Luna José Roberto Mendoza Pastor

50

### 4.6 Multiplexión

Una vez que se tiene el módulo completo de amplificación construido y funcionando, se procede al diseño de la etapa de multiplexión, esta etapa tiene gran importancia, ya que es la que nos va a permitir visualizar los 32 canales. Primero se procede al análisis de los elementos, debido a que la tarjeta de la computadora es estéreo, contamos con dos canales de entrada, por lo cual se utilizarán dos módulos de amplificación, una vez mencionada esta consideración, continuamos con el diseño de la multiplexión.

En un estudio estándar de electroencefalografía, se cuenta con un total de 21 electrodos y se colocan de la manera en que muestra la figura 28:

Fig. 28 Posición de los eléctrodos.

Con esta colocación se tiene la posibilidad de hacer un registro longitudinal o un registro transversal.

## 4. Diseño y Construcción del EEG

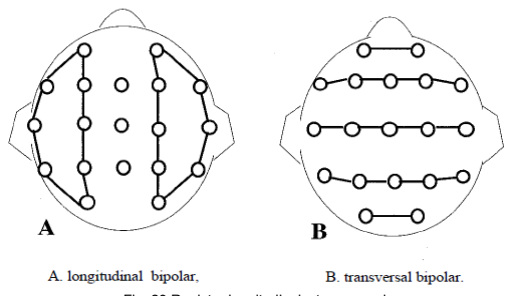
[picture p37: figure]

### Juan Alejandro Alonso Toledo Herson Daniel Diaz Luna José Roberto Mendoza Pastor

51

Fig. 29 Registro longitudinal y transversal.

En la siguiente tabla se muestran las comparaciones que se hacen para cada canal dependiendo el tipo de registro:

Canal | Longitudinal | Transversal | Canal | Longitudinal | Transversal
1 | FP1 - F3 | FP1 – FP2 | 9 | FP1 – F7 | Cz – C4
2 | F3 - C3 | F7 – F3 | 10 | F7 – T3 | C4 – T4
3 | C3 – P3 | F3 – Fz | 11 | T3 – T5 | T4 – A2
4 | P3 – O1 | Fz – F4 | 12 | T5 – O1 | T5 – P3
5 | FP2 – F4 | F4 – F8 | 13 | FP2 – F8 | P3 – Fz
6 | F4 – C4 | A1 – T3 | 14 | F8 – T4 | Pz – P4
7 | C4 – P4 | T3 – C3 | 15 | T4 – T6 | P4 – T6
8 | P4 – O2 | C3 – Cz | 16 | T4 – O2 | O1 – O2

Como se observa son 16 canales por cada tipo de registro, esto da la pauta a que el equipo diseñado registre esos 32 canales de manera que se obtienen en un solo estudio sin mayor complicación, para lograr esto con solo dos módulos de amplificación se requiere de una multiplexión.

Un multiplexor es un selector de datos, es decir, que permite la entrada de datos desde varias fuentes, pero solo permite la salida a una de ellas, dicha salida es controlada digitalmente, manipulando las llamadas entradas de selección. A continuación se muestra el diagrama funcional de un multiplexor:

## 4. Diseño y Construcción del EEG

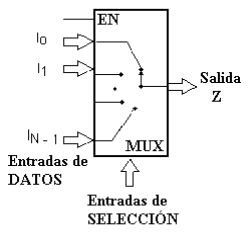
[picture p38: figure]

### Juan Alejandro Alonso Toledo Herson Daniel Diaz Luna José Roberto Mendoza Pastor

52

Fig. 30 Diagrama funcional de un multiplexor.

Las flechas de entrada se representan de esa manera para mostrar que no se refiere solo a una línea de entrada sino que pueden ser varias líneas, la línea de entrada marcada con “EN” se refiere al habilitador, la cual se coloca en un potencial cero para que el multiplexor funcione.

Para el control del multiplexor, que como ya se mencionó se hace de manera digital, se empleo una memoria EEPROM, la cual tiene los datos de control de cada multiplexor, de esta manera cada uno de los multiplexores sabe qué señal es la que debe de mandar a la salida, a su vez esta memoria es controlada por un contador binario de 4 bits, esto con la finalidad de que el control de cada multiplexor se lleve a cabo de manera autónoma, y por último se implementó mediante un temporizador una señal de reloj, requerida por el contador, con frecuencia de 1Hz para que cada señal sea muestreada por periodos de 1 segundo.

Para la implementación se eligieron los multiplexores de la serie CD405X, estos son multiplexores que manejan tanto señales digitales así como analógicas de hasta 20Vp-p, tiene un tiempo de propagación de 20ns y un manejo de ancho de banda de hasta 10MHz, tomando en cuenta estas características principales se adaptan fácilmente a las necesidades de nuestro diseño.

Si bien ya mencionamos las características de los multiplexores, cabe señalar que no fueron explotados al 100%, ya que las señales de entrada que se manejan son de una magnitud muy pequeña, este mismo multiplexor nos permite manejarlas sin distorsión considerable ni ruido, también el rango que maneja para las señales analógicas permite tener una libertad total en las señales como se muestra en la siguiente gráfica, cabe señalar que la respuesta en el rango es prácticamente lineal.

## 4. Diseño y Construcción del EEG

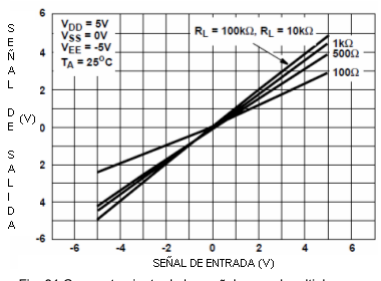
[picture p39: figure]

### Juan Alejandro Alonso Toledo Herson Daniel Diaz Luna José Roberto Mendoza Pastor

53

Fig. 31 Comportamiento de las señales en el multiplexor.

## 4. Diseño y Construcción del EEG

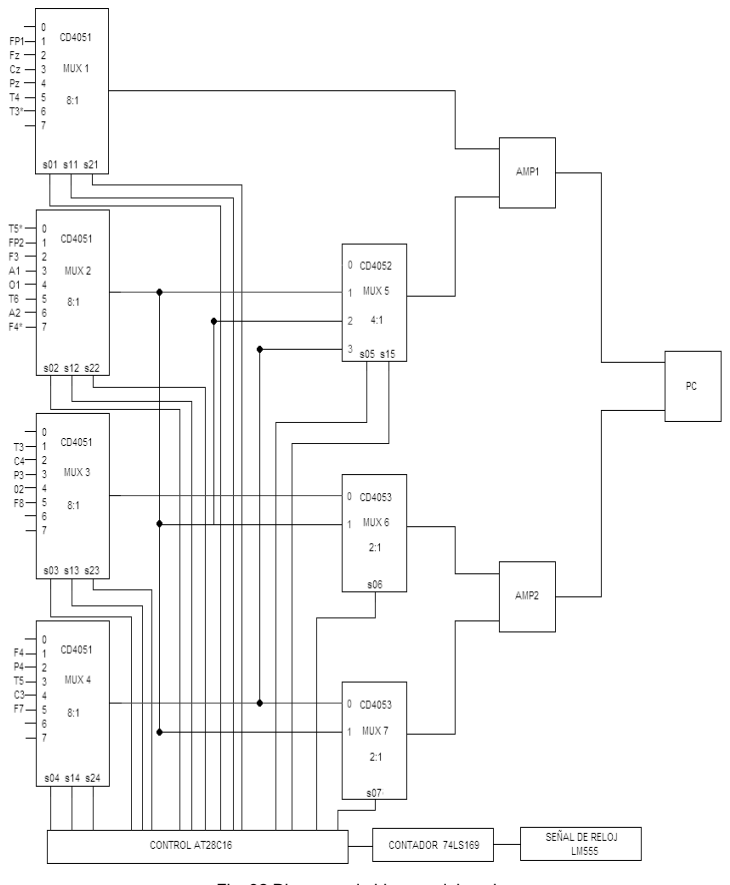
[picture p40: figure]

### Juan Alejandro Alonso Toledo Herson Daniel Diaz Luna José Roberto Mendoza Pastor

54

Fig. 32 Diagrama de bloques del equipo.

## 4. Diseño y Construcción del EEG

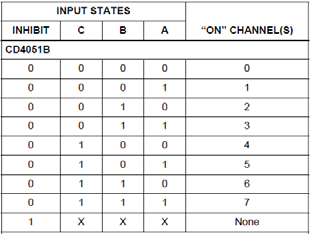
[picture p41: figure]
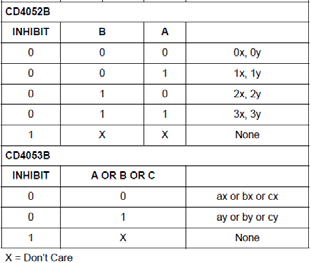
[picture p42: figure]

### Juan Alejandro Alonso Toledo Herson Daniel Diaz Luna José Roberto Mendoza Pastor

55

Como se observa se utilizan tres diferentes multiplexores, el CD4051, el CD4052 y el CD4053.

El CD4051 es un multiplexor 8:1, se utilizan 4 de este tipo, en el se conectan todos los electrodos, estos son los que llevarán el control principal de cada uno de ellos, según el canal que vaya a ser muestreado será la señal que manden a la salida, a la salida de ellos encontramos que la salida del MUX1 va directamente hacia una entrada del amplificador 1(AMP1), sin embargo las salidas de los MUX2, MUX3 y MUX4 se dirigen a otro grupo de multiplexores, en el caso del MUX5 se trata de un CD4052 que es un multiplexor 4:1, mientras que los MUX6 y MUX7 son CD4053 que son multiplexores 2:1, esta disposición fue necesaria para manejar toda la combinación que se debe hacer de las señales de los electrodos para registrar los 32 canales, como se observa dependiendo del canal que se vaya a muestrear, serán enviados los datos a la entrada de control de cada uno de los multiplexores por la memoria para que de esta manera las señales sean enviadas a cada una de las entradas de los amplificadores, y a la salida de estos últimos a cada uno de los canales de la computadora y de esta manera sean visualizados.

A continuación se presenta la tabla de verdad de cada uno de los multiplexores:

Tabla 1 Tabla de verdad de los multiplexores.

## 4. Diseño y Construcción del EEG

### Juan Alejandro Alonso Toledo Herson Daniel Diaz Luna José Roberto Mendoza Pastor

56

Como se había mencionado para el control de los multiplexores se utilizó una EEPROM, lo cual significa que es una memoria de solo lectura, además de no ser volátil, lo cual garantiza que se tendrán los datos aunque la alimentación sea desconectada, en este caso se eligió la AT28C16, que es una memoria de 64Kb, es decir, almacena 8192 palabras de 8 bits cada una, si bien debemos señalar que está muy sobrada en cuanto a capacidad para la aplicación, la disposición de entradas y salidas es perfecta, y considerando la relación precio beneficio se optó por ésta, utilizamos 2 módulos de memoria, y con ello se logró cubrir por completo cada una de las entradas de control de los multiplexores.

Los resultados del análisis que se hizo se para determinar como se llevaría a cabo el control se presentan en la siguiente tabla, es decir, se analizo la señal de que electrodo se requería en cada instante y de esta manera saber que señal se debía mandar a cada uno de los multiplexores:

## 4. Diseño y Construcción del EEG

### Juan Alejandro Alonso Toledo Herson Daniel Diaz Luna José Roberto Mendoza Pastor

57

Combinaciones | Canales | Control
Mux 1 | Mux 2 | Mux 3 | Mux 4 | Mux 5 | Mux 6 | Mux 7
FP1-F3 | C3-P3 | 1 | 2 | 1 | 2 | 3 | 4 | 1 | 0 | 0
F3-C3 | F8-T4 | 3 | 4 | 5 | 2 | 5 | 4 | 2 | 1 | 0
P3-O1 | FP1-F7 | 5 | 6 | 1 | 4 | 3 | 5 | 3 | 0 | 1
FP2-F4 | T4-O2 | 7 | 8 | 5 | 1 | 4 | 1 | 2 | 1 | 0
F4-C4 | T4-T6 | 9 | 10 | 5 | 5 | 2 | 1 | 1 | 0 | 0
C4-P4 | FP1-FP2 | 11 | 12 | 1 | 1 | 2 | 2 | 1 | 0 | 0
P4-O2 | F3-Fz | 13 | 14 | 2 | 2 | 4 | 2 | 1 | 0 | 0
F7-T3 | T4-A2 | 15 | 16 | 5 | 6 | 1 | 5 | 1 | 0 | 0
T3-T5 | F4-F8 | 17 | 18 | 6 | 7 | 5 | 3 | 3 | 0 | 1
T5-O1 | Cz-C4 | 19 | 20 | 3 | 4 | 2 | 3 | 2 | 1 | 0
FP2-F8 | Fz-F4 | 21 | 22 | 2 | 1 | 5 | 1 | 3 | 0 | 1
F7-F3 | C4-T4 | 23 | 24 | 5 | 2 | 2 | 5 | 2 | 1 | 0
T3-C3 | T5-P3 | 25 | 26 | 6 | 0 | 3 | 4 | 3 | 0 | 1
C3-Cz | O1-O2 | 27 | 28 | 3 | 4 | 4 | 4 | 3 | 0 | 1
P3-Fz | P4-T6 | 29 | 30 | 2 | 5 | 3 | 2 | 2 | 1 | 0
Pz-P4 | A1-T3 | 31 | 32 | 4 | 3 | 1 | 2 | 3 | 0 | 1

Tabla 2 Tabla de control de los multiplexores.

Una vez que ya se tiene hecha la tabla de verdad para el manejo de los multiplexores se procede a transformar la información a datos binarios para de esta manera obtener los datos que se grabaron en cada una de las memorias.

El primer módulo de memoria maneja los multiplexores 1, 2 y 5, mientras que el otro módulo maneja los multiplexores 3, 4, 6 y 7.

La tabla que se presenta a continuación ya contiene los datos en la forma que se grabaron en cada una de las memorias, mostrando a qué canal pertenece, y también qué datos recibe cada multiplexor:

## 4. Diseño y Construcción del EEG

### Juan Alejandro Alonso Toledo Herson Daniel Diaz Luna José Roberto Mendoza Pastor

58

Canales | Control
Mux1 | Mux2 | Mux3 | Mux4 | Mux5 | Mux6 | Mux7
1 | 2 | 0 | 0 | 1 | 0 | 1 | 0 | 0 | 1 | 1 | 1 | 0 | 0 | 0 | 1 | 0 | 0
3 | 4 | 1 | 0 | 1 | 0 | 1 | 0 | 1 | 0 | 1 | 1 | 0 | 0 | 1 | 0 | 1 | 0
5 | 6 | 0 | 0 | 1 | 1 | 0 | 0 | 0 | 1 | 1 | 1 | 0 | 1 | 1 | 1 | 0 | 1
7 | 8 | 1 | 0 | 1 | 0 | 1 | 0 | 1 | 0 | 0 | 0 | 0 | 1 | 1 | 0 | 1 | 0
9 | 10 | 1 | 0 | 1 | 1 | 0 | 1 | 0 | 1 | 0 | 0 | 0 | 1 | 0 | 1 | 0 | 0
11 | 12 | 0 | 0 | 1 | 0 | 0 | 1 | 0 | 1 | 0 | 0 | 1 | 0 | 0 | 1 | 0 | 0
13 | 14 | 0 | 1 | 0 | 0 | 1 | 0 | 1 | 0 | 0 | 0 | 1 | 0 | 0 | 1 | 0 | 0
15 | 16 | 1 | 0 | 1 | 1 | 1 | 0 | 0 | 0 | 1 | 1 | 0 | 1 | 0 | 1 | 0 | 0
17 | 18 | 1 | 1 | 0 | 1 | 1 | 1 | 1 | 0 | 1 | 0 | 1 | 1 | 1 | 1 | 0 | 1
19 | 20 | 0 | 1 | 1 | 1 | 0 | 0 | 0 | 1 | 0 | 0 | 1 | 1 | 1 | 0 | 1 | 0
21 | 22 | 0 | 1 | 0 | 0 | 0 | 1 | 1 | 0 | 1 | 0 | 0 | 1 | 1 | 1 | 0 | 1
23 | 24 | 1 | 0 | 1 | 0 | 1 | 0 | 0 | 1 | 0 | 1 | 0 | 1 | 1 | 0 | 1 | 0
25 | 26 | 1 | 1 | 0 | 0 | 0 | 0 | 0 | 1 | 1 | 1 | 0 | 0 | 1 | 1 | 0 | 1
27 | 28 | 0 | 1 | 1 | 1 | 0 | 0 | 1 | 0 | 0 | 1 | 0 | 0 | 1 | 1 | 0 | 1
29 | 30 | 0 | 1 | 0 | 1 | 0 | 1 | 0 | 1 | 1 | 0 | 1 | 0 | 1 | 0 | 1 | 0
31 | 32 | 1 | 0 | 0 | 0 | 1 | 1 | 0 | 0 | 1 | 0 | 1 | 0 | 1 | 1 | 0 | 1

Tabla 3 Datos de control.

Como se observa en el diagrama de bloques las memorias están conectadas a su vez a un contador, que en este caso es un 74LS169, se trata de un contador síncrono de 4 bits, al ser de 4 bits, nos permite hacer una cuenta de 16 números, es decir desde cero hasta 15, todo esto de manera digital, tomando en consideración esto y sabiendo que debemos muestrear 32 canales sacamos ventaja de este hecho.

Puesto que son 32 canales a muestrear, y se cuenta con dos entradas en la computadora, es decir se muestrean 2 canales de manera simultánea, y por lo tanto es como si fueran solamente 16 canales, resulta ser la cuenta exacta que ofrece el “chip”.
De esta manera las salidas del contador van conectadas de manera directa a cada memoria, por lo que se logra manipular las entradas de la memoria, cada vez que el contador aumenta una unidad la memoria accede a otra dirección de datos en su interior, lo cual ocasiona que mande otros datos a su salida y por lo tanto los multiplexores mandarán ahora lo que se les indique. El contador realiza su cuenta de manera continua, sin embargo se debe considerar que cuando se prenda el dispositivo no sabemos en qué número se encuentra la cuenta, por lo cual para identificar qué canal se observa se debe asegurar que la cuenta siempre comience en cero cuando es encendido, para esto se introduce un botón, que al ser apretado manda el contador al inicio de la cuenta, de

## 4. Diseño y Construcción del EEG

### Juan Alejandro Alonso Toledo Herson Daniel Diaz Luna José Roberto Mendoza Pastor

59

esta forma se asegura aseguramos que siempre sea cero al inicio y se identifica el canal que se está observando.
Cabe señalar que dicho contador requiere una señal de reloj, esta señal lo que hace es que cada que le llegue un pulso positivo al contador aumenta una unidad a la cuenta, observamos que gracias a este hecho se puede manipular el tiempo que se desea que sean muestreados cada par de canales, en este caso se decidió poner una señal de 1Hz para lograr que cada par de canales sean visualizados por 1 segundo.

Para generar esta señal de reloj, se utilizó un temporizador LM555 en su configuración astable con ciclo de trabajo de 50%, los valores de los componentes para lograr la señal de las características ya mencionadas se observan en el diagrama final de conexiones que se muestra en la figura 33:

## 4. Diseño y Construcción del EEG

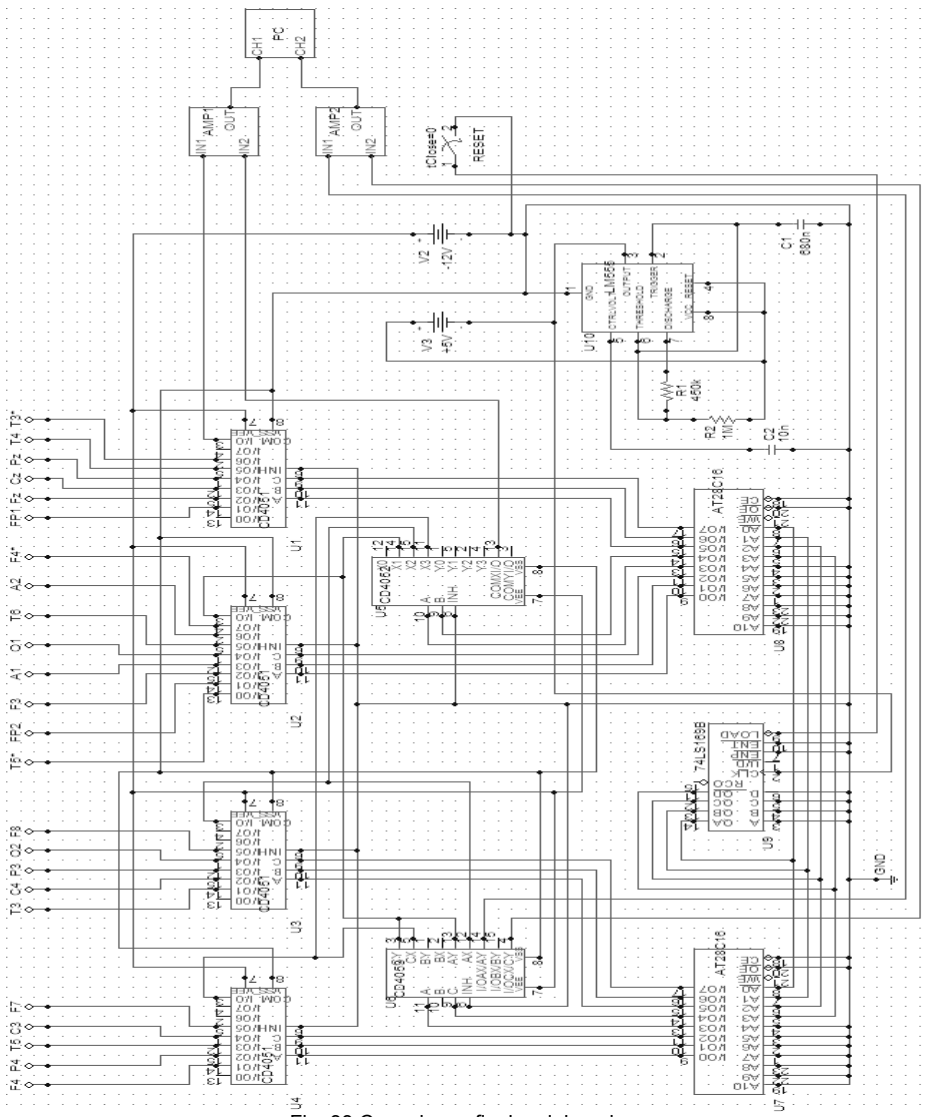
[picture p43: figure]

### Juan Alejandro Alonso Toledo Herson Daniel Diaz Luna José Roberto Mendoza Pastor

60

Fig. 33 Conexiones finales del equipo.

## 4. Diseño y Construcción del EEG

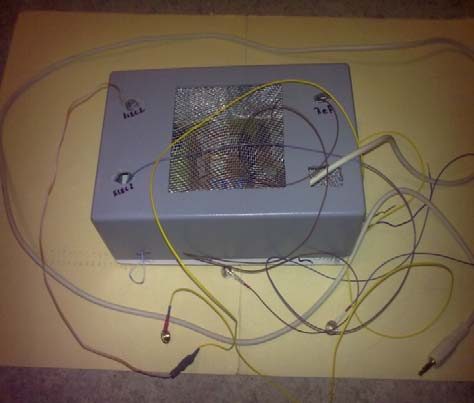
[picture p44: figure]
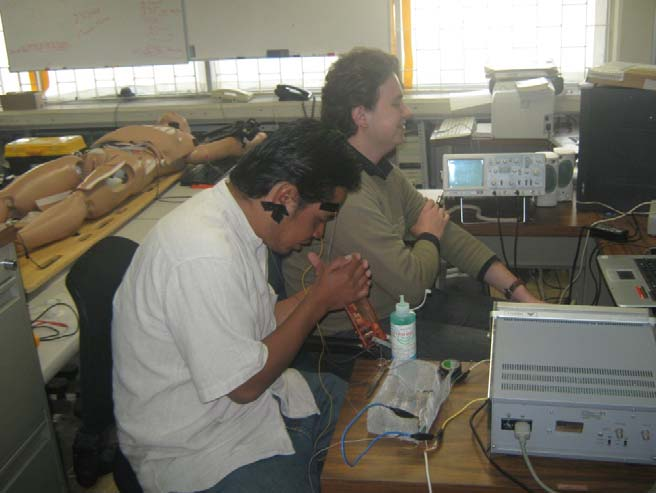
[picture p45: figure]

### Juan Alejandro Alonso Toledo Herson Daniel Diaz Luna José Roberto Mendoza Pastor

61

Fig. 34 Dispositivo final.

Fig. 35 Prueba del equipo.
