sabas1080/Moonmakers_Cerebro/Hardware/.svg2shenzhen-cache/images/B.Mask_g828.png

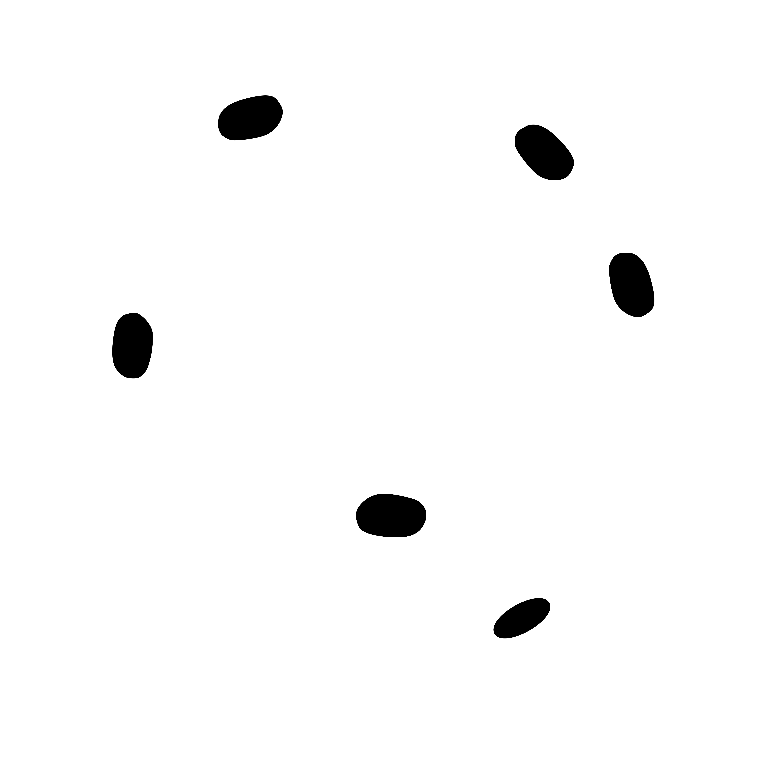
Hardware/.svg2shenzhen-cache/images/B.Mask_g828.png
