sabas1080/Moonmakers_Cerebro/Hardware/.svg2shenzhen-cache/images/F.Cu_g832.png

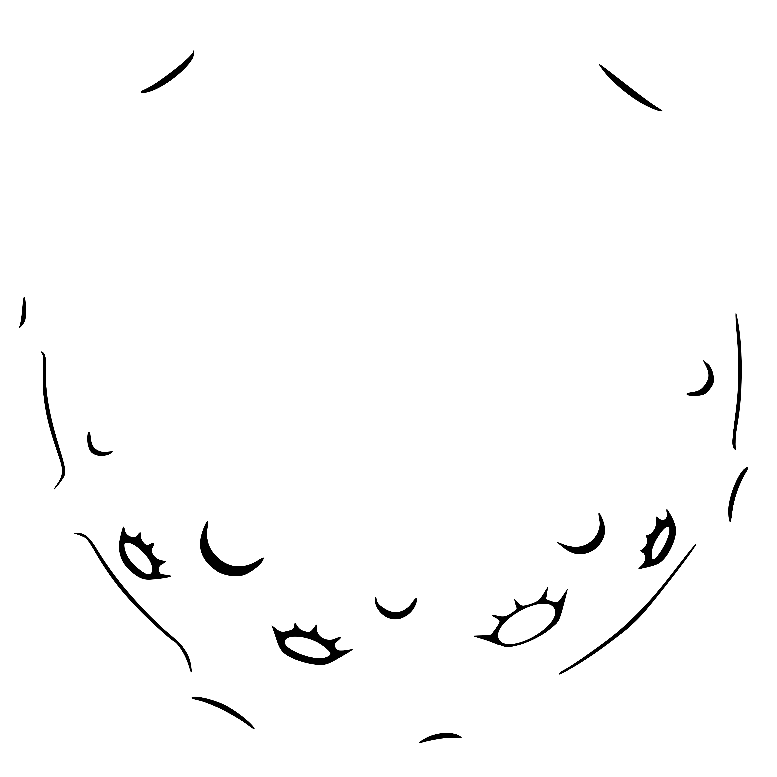
Hardware/.svg2shenzhen-cache/images/F.Cu_g832.png
