sabas1080/Moonmakers_Cerebro/Hardware/.svg2shenzhen-cache/images/F.Mask_g1678.png

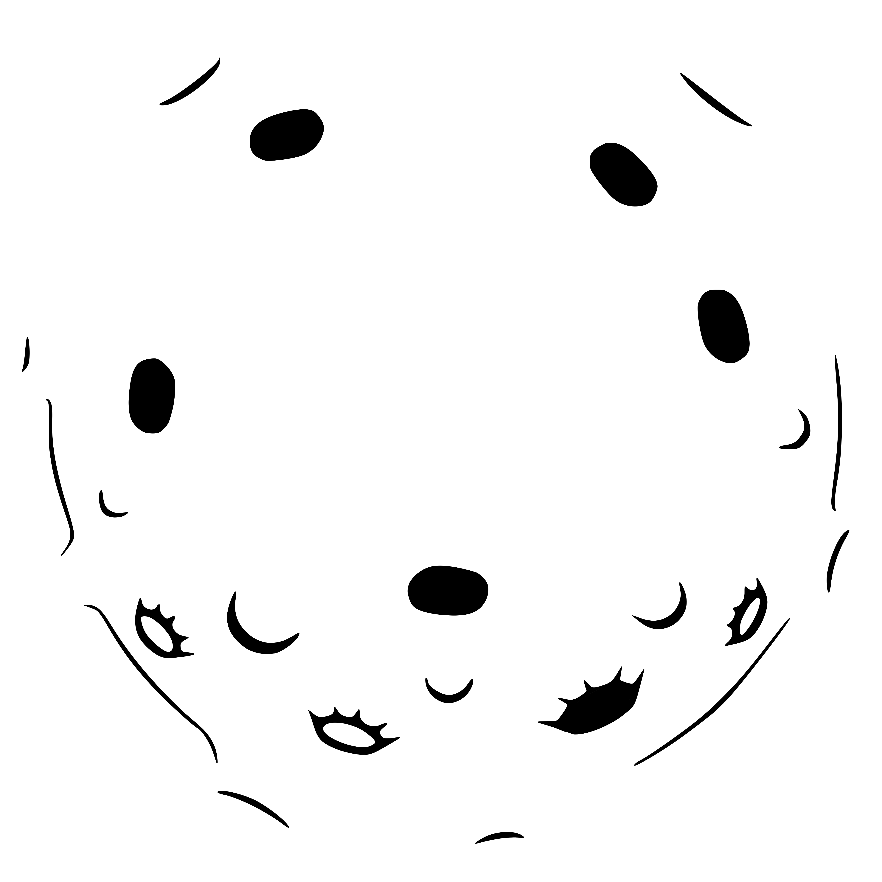
Hardware/.svg2shenzhen-cache/images/F.Mask_g1678.png
