sabas1080/Moonmakers_Cerebro/Hardware/.svg2shenzhen-cache/images/F.Silk_g836.png

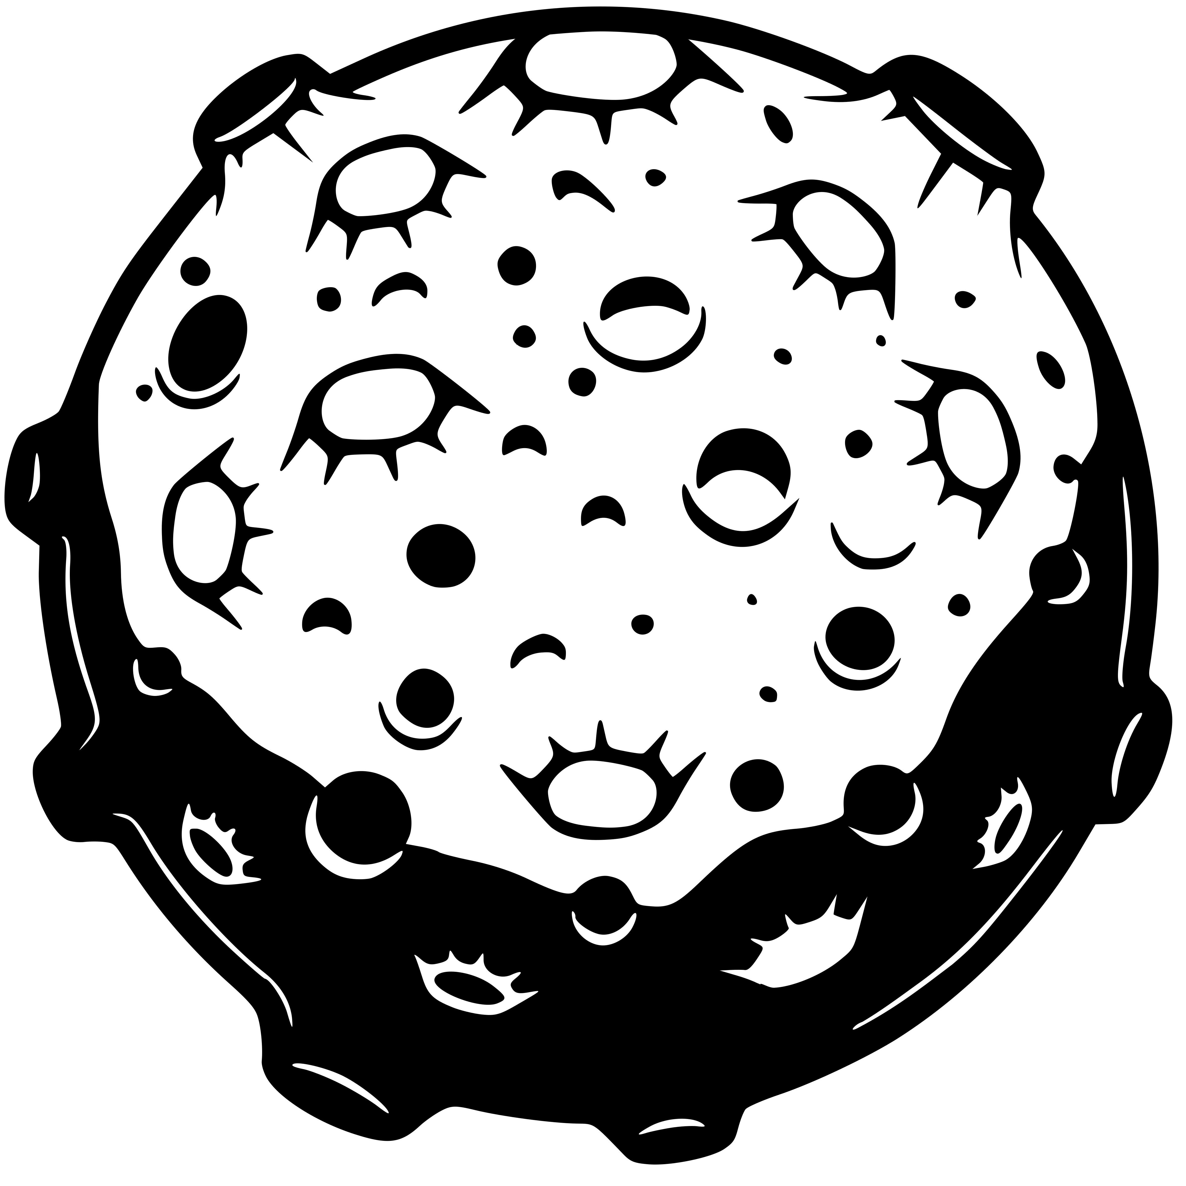
Hardware/.svg2shenzhen-cache/images/F.Silk_g836.png
