sabas1080/Moonmakers_Cerebro/www/DIY EEG_files/F1OL5RJH3QFJ1G9.LARGE.jpg

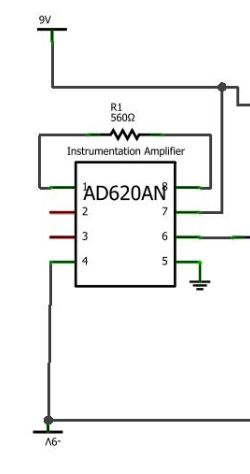
www/DIY EEG_files/F1OL5RJH3QFJ1G9.LARGE.jpg
