sabas1080/Moonmakers_Cerebro/www/DIY EEG_files/F2T5L7VH3QFL7V3.LARGE.jpg

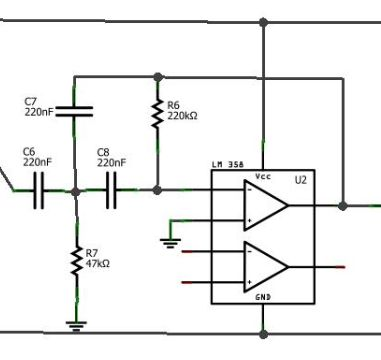
www/DIY EEG_files/F2T5L7VH3QFL7V3.LARGE.jpg
