sabas1080/Moonmakers_Cerebro/www/DIY EEG_files/F4E677UK1B4CZXX.LARGE.jpg

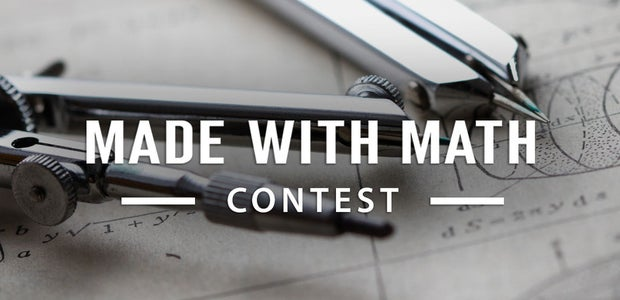
www/DIY EEG_files/F4E677UK1B4CZXX.LARGE.jpg
