sabas1080/Moonmakers_Cerebro/www/DIY EEG_files/F6S5VK1K2262C0N.MEDIUM.jpg

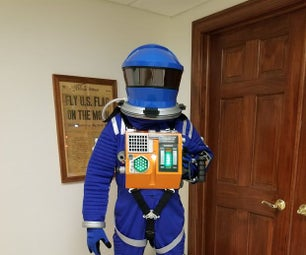
www/DIY EEG_files/F6S5VK1K2262C0N.MEDIUM.jpg
