sabas1080/Moonmakers_Cerebro/www/DIY EEG_files/F6TBRB3J7GGGQ7P.MEDIUM.jpg

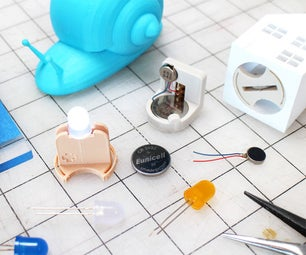
www/DIY EEG_files/F6TBRB3J7GGGQ7P.MEDIUM.jpg
