sabas1080/Moonmakers_Cerebro/www/DIY EEG_files/F9Q7EO6H3QFJN23.LARGE.jpg

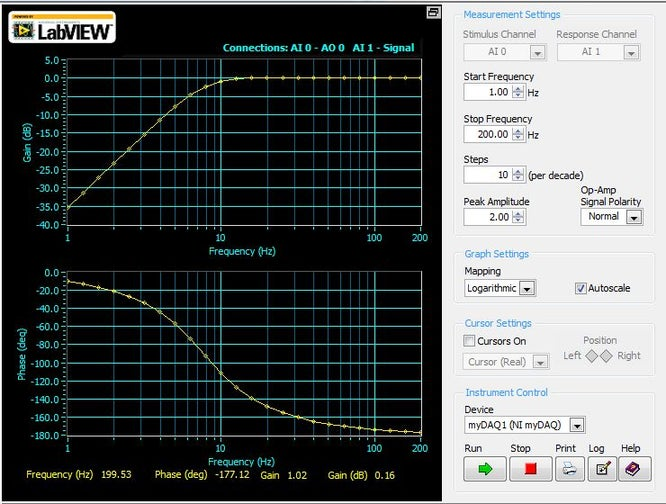
www/DIY EEG_files/F9Q7EO6H3QFJN23.LARGE.jpg
