sabas1080/Moonmakers_Cerebro/www/DIY EEG_files/F22KAB3H3ZN4VY6.LARGE.jpg

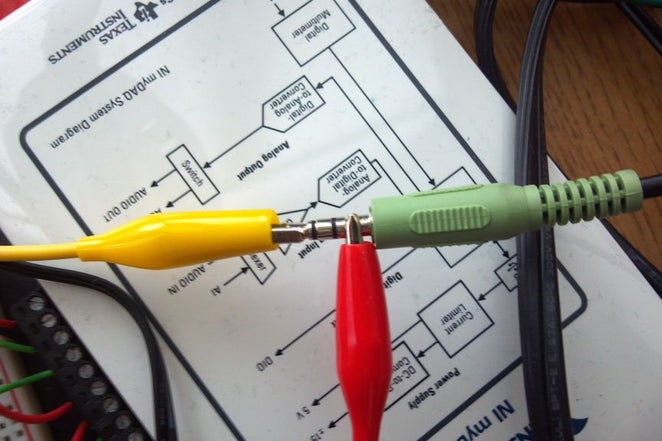
www/DIY EEG_files/F22KAB3H3ZN4VY6.LARGE.jpg
