sabas1080/Moonmakers_Cerebro/www/DIY EEG_files/F84IFCQILJWFL96.LARGE.jpg

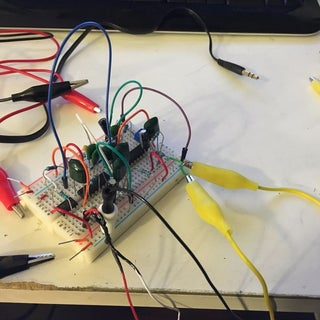
www/DIY EEG_files/F84IFCQILJWFL96.LARGE.jpg
