sabas1080/Moonmakers_Cerebro/www/DIY EEG_files/F94TYG6H3QFJ1IY.LARGE.jpg

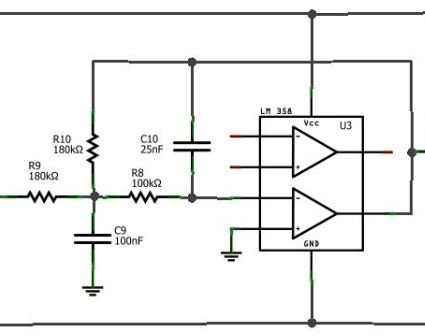
www/DIY EEG_files/F94TYG6H3QFJ1IY.LARGE.jpg
