sabas1080/Moonmakers_Cerebro/www/DIY EEG_files/FA1G314J66Q8EQM.MEDIUM.jpg

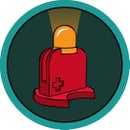
www/DIY EEG_files/FA1G314J66Q8EQM.MEDIUM.jpg
