sabas1080/Moonmakers_Cerebro/www/DIY EEG_files/FB5LWP9H3QFM1WR.LARGE.jpg

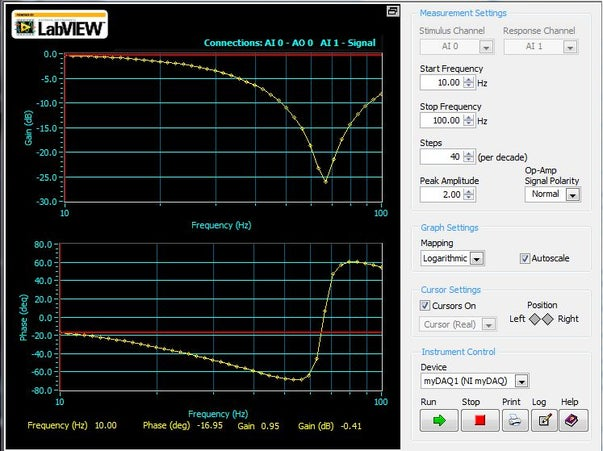
www/DIY EEG_files/FB5LWP9H3QFM1WR.LARGE.jpg
