sabas1080/Moonmakers_Cerebro/www/DIY EEG_files/FDU9J7JK10ZGGVZ.MEDIUM.jpg

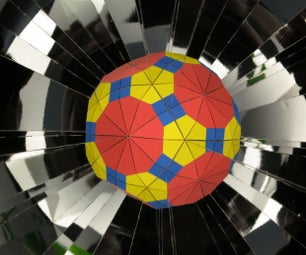
www/DIY EEG_files/FDU9J7JK10ZGGVZ.MEDIUM.jpg
