sabas1080/Moonmakers_Cerebro/www/DIY EEG_files/FEHC1XAH5TU9RMD.LARGE.gif

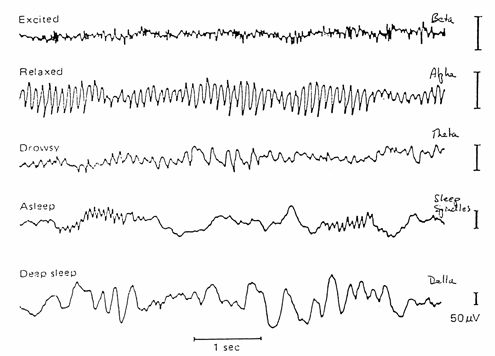
www/DIY EEG_files/FEHC1XAH5TU9RMD.LARGE.gif
