sabas1080/Moonmakers_Cerebro/www/DIY EEG_files/FET52NJI5MD7MC7.LARGE.jpg

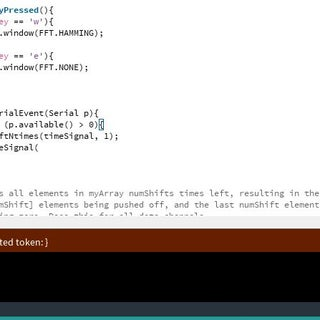
www/DIY EEG_files/FET52NJI5MD7MC7.LARGE.jpg
