sabas1080/Moonmakers_Cerebro/www/DIY EEG_files/FEZD0WJHU8420YL.LARGE.jpg

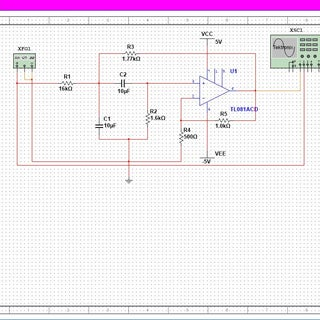
www/DIY EEG_files/FEZD0WJHU8420YL.LARGE.jpg
