sabas1080/Moonmakers_Cerebro/www/DIY EEG_files/FH9V3GWH5JVXVJC.LARGE.jpg

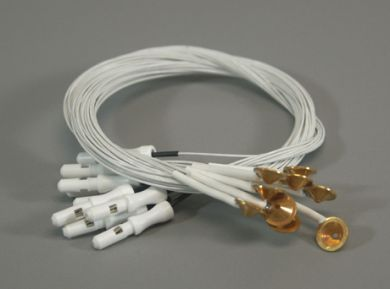
www/DIY EEG_files/FH9V3GWH5JVXVJC.LARGE.jpg
