sabas1080/Moonmakers_Cerebro/www/DIY EEG_files/FH44LLSK00V1658.LARGE.jpg

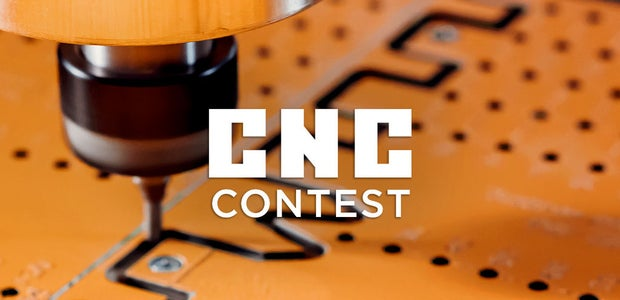
www/DIY EEG_files/FH44LLSK00V1658.LARGE.jpg
