sabas1080/Moonmakers_Cerebro/www/DIY EEG_files/FIQ08M0K2262AP6.MEDIUM.jpg

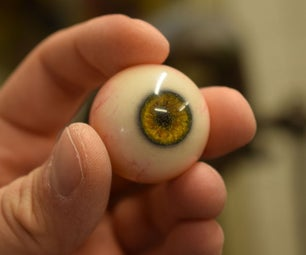
www/DIY EEG_files/FIQ08M0K2262AP6.MEDIUM.jpg
