sabas1080/Moonmakers_Cerebro/www/DIY EEG_files/FNPSS4WH3QF1FD0.LARGE.jpg

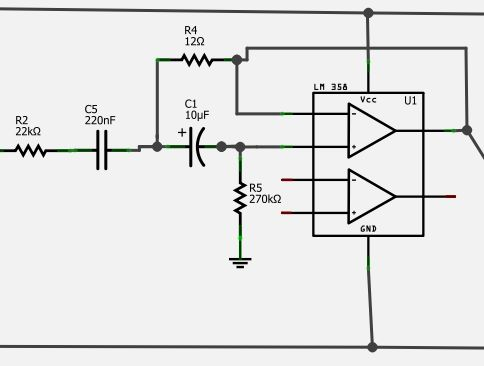
www/DIY EEG_files/FNPSS4WH3QF1FD0.LARGE.jpg
