sabas1080/Moonmakers_Cerebro/www/DIY EEG_files/FPGQOXAH3QFJ1IX.LARGE.jpg

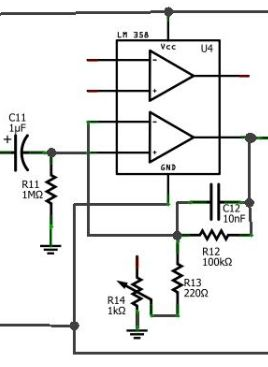
www/DIY EEG_files/FPGQOXAH3QFJ1IX.LARGE.jpg
