sabas1080/Moonmakers_Cerebro/www/DIY EEG_files/FPIKH7BJ86HR367.LARGE.jpg

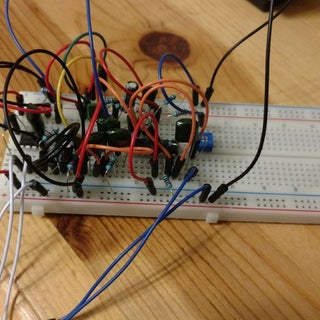
www/DIY EEG_files/FPIKH7BJ86HR367.LARGE.jpg
