sabas1080/Moonmakers_Cerebro/www/DIY EEG_files/FQ47TBNH401UZ2Y.LARGE.jpg

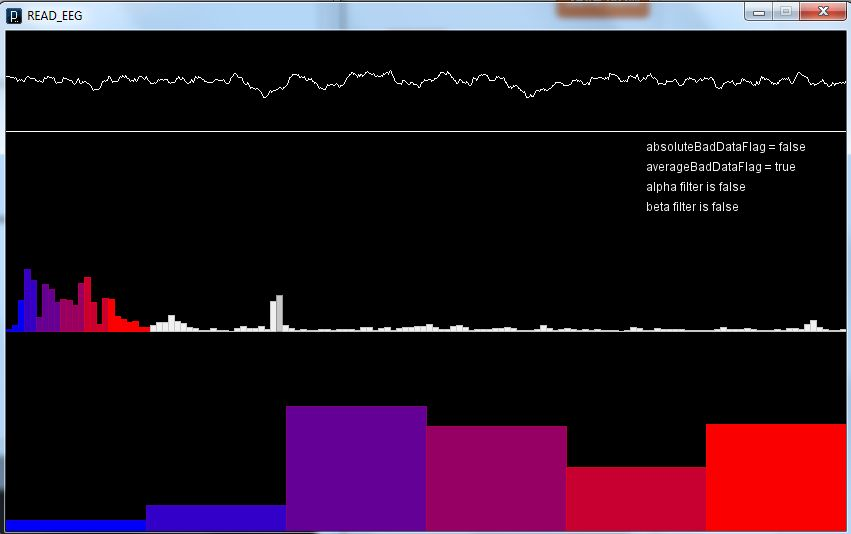
www/DIY EEG_files/FQ47TBNH401UZ2Y.LARGE.jpg
