sabas1080/Moonmakers_Cerebro/www/DIY EEG_files/FR5NQTRH3QFL7UP.LARGE.jpg

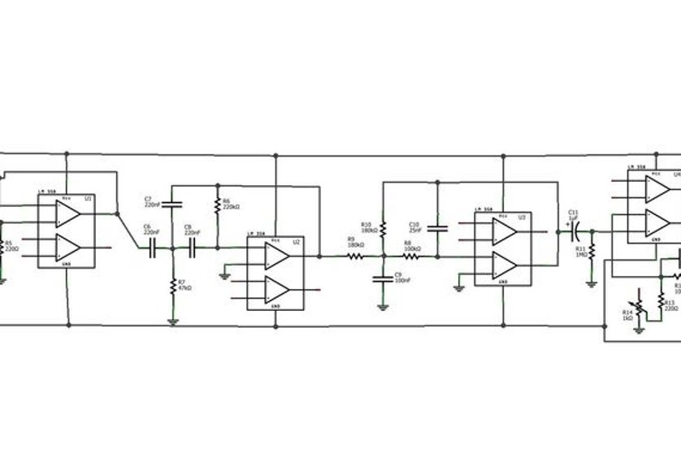
www/DIY EEG_files/FR5NQTRH3QFL7UP.LARGE.jpg
