sabas1080/Moonmakers_Cerebro/www/DIY EEG_files/FRMOY7TI5BSD3KW.LARGE.jpg

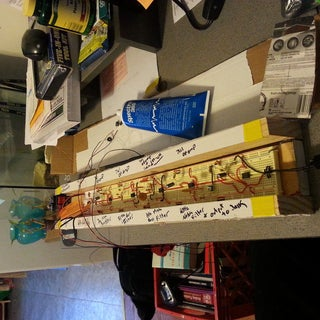
www/DIY EEG_files/FRMOY7TI5BSD3KW.LARGE.jpg
