sabas1080/Moonmakers_Cerebro/www/DIY EEG_files/FROY9DRH461X1ZN.LARGE.jpg

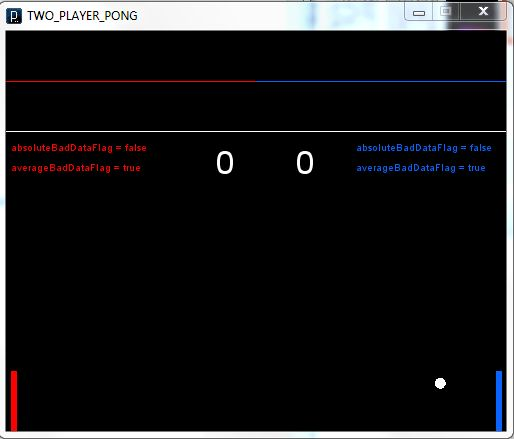
www/DIY EEG_files/FROY9DRH461X1ZN.LARGE.jpg
