sabas1080/Moonmakers_Cerebro/www/DIY EEG_files/FSBCVH8K02P1XOI.LARGE.jpg

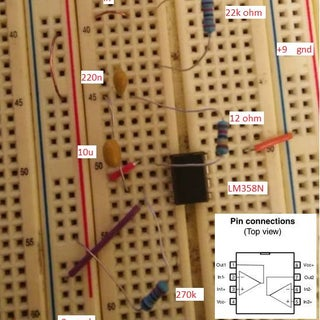
www/DIY EEG_files/FSBCVH8K02P1XOI.LARGE.jpg
