sabas1080/Moonmakers_Cerebro/www/DIY EEG_files/FTYHDPFH6MF2WPG.LARGE.jpg

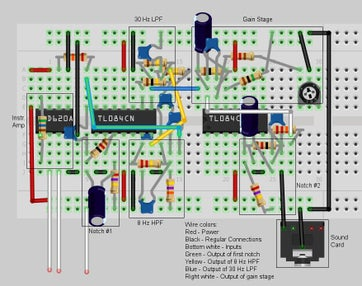
www/DIY EEG_files/FTYHDPFH6MF2WPG.LARGE.jpg
