sabas1080/Moonmakers_Cerebro/www/DIY EEG_files/FUU8JEUK02P1XHG.LARGE.jpg

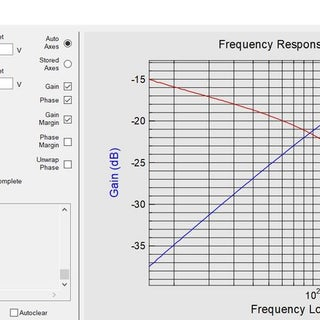
www/DIY EEG_files/FUU8JEUK02P1XHG.LARGE.jpg
