sabas1080/Moonmakers_Cerebro/www/DIY EEG_files/FUVVMQ0H3QEXKLR.LARGE.jpg

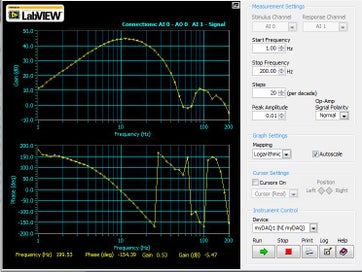
www/DIY EEG_files/FUVVMQ0H3QEXKLR.LARGE.jpg
