sabas1080/Moonmakers_Cerebro/www/DIY EEG_files/FUYEDNAH3QETR43.LARGE.jpg

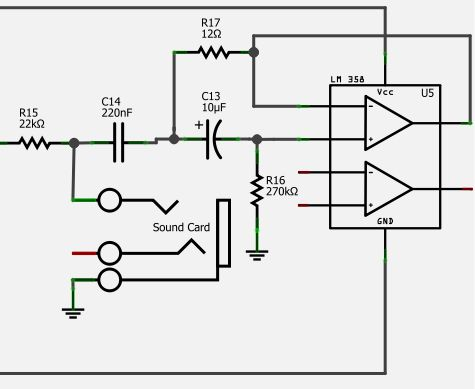
www/DIY EEG_files/FUYEDNAH3QETR43.LARGE.jpg
