sabas1080/Moonmakers_Cerebro/www/DIY EEG_files/FW512F8K1B3F7UO.LARGE.jpg

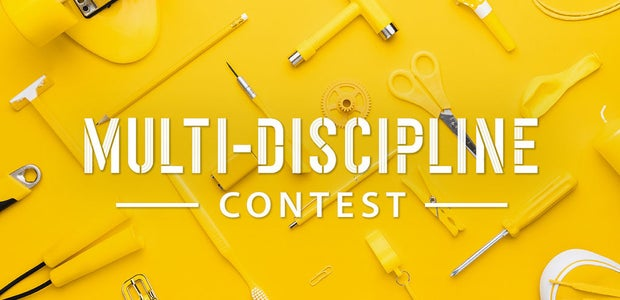
www/DIY EEG_files/FW512F8K1B3F7UO.LARGE.jpg
