sabas1080/Moonmakers_Cerebro/www/DIY EEG_files/FWOJ4RIJDKKGICQ.LARGE.jpg

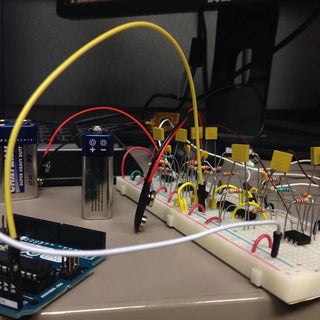
www/DIY EEG_files/FWOJ4RIJDKKGICQ.LARGE.jpg
