sabas1080/Moonmakers_Cerebro/www/DIY EEG_files/MCU_C2X_F2838x_300x250_st.gif

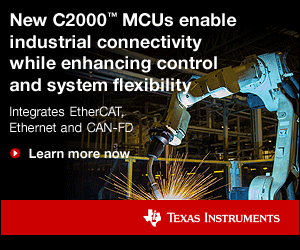
www/DIY EEG_files/MCU_C2X_F2838x_300x250_st.gif
