sabas1080/Moonmakers_Cerebro/Hardware/Cerebro.pdf

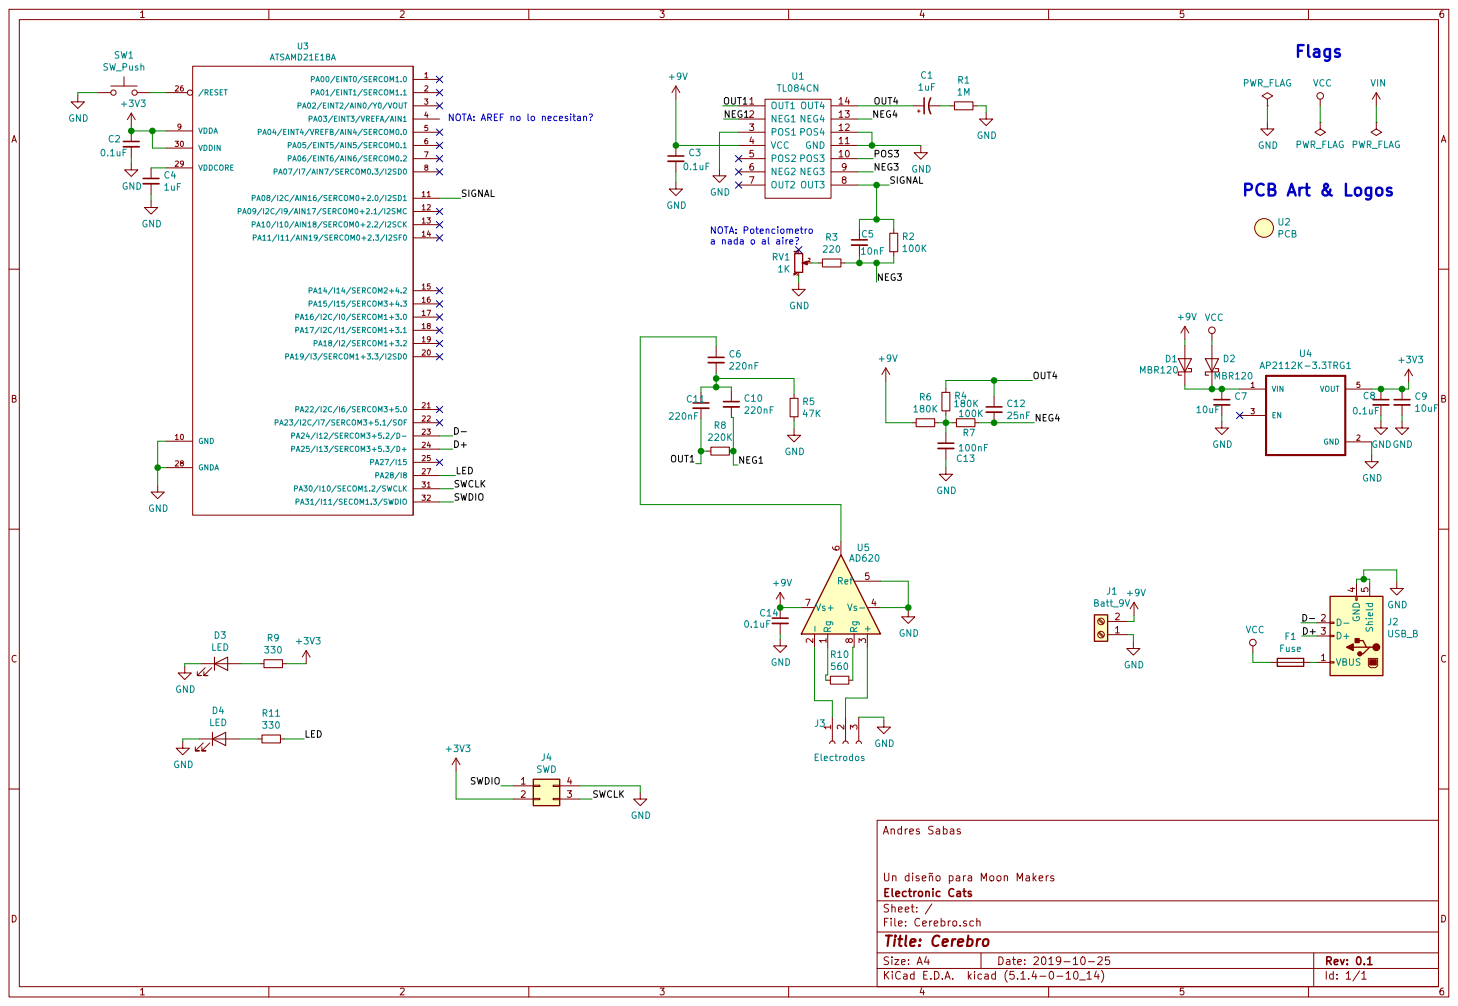
[picture p83: page 1]

File: Cerebro.sch Sheet: / Electronic Cats Un diseño para Moon Makers Andres Sabas
