sabas1080/Moonmakers_Cerebro/Hardware/Cerebro.kicad_pcb

## KiCad design Hardware/Cerebro.kicad_pcb (2019-10-25)

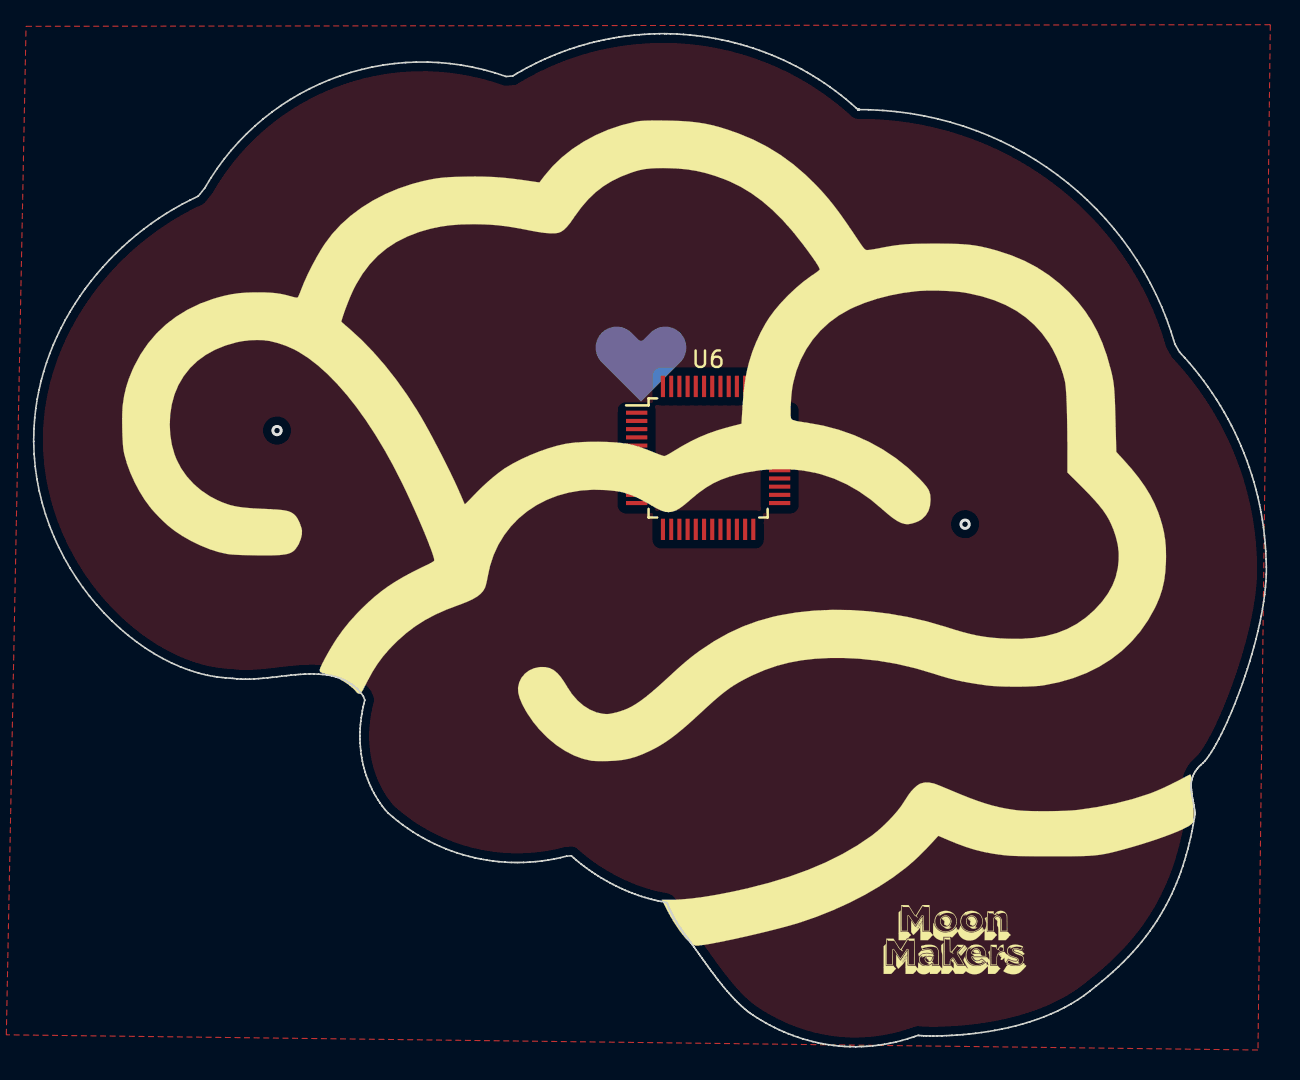
[picture p84: board Cerebro.kicad_pcb from above]

Board: 2 copper layers, 75.0 x 61.7 mm, 3 parts (1 on the bottom side), 2 nets, no tracks yet.

Parts:
Ref**: Val**; Cerebro_001
U6: ATSAMD21G18A-AUT; TQFP-48_7x7mm_P0.5mm
svg2mod: G***; heart

Connections:
unnamed: U6.17, U6.36
unnamed: U6.18, U6.35, U6.42
