sabas1080/Moonmakers_Cerebro/(commit log)

2019-10-25 initial commits
    [Cerebro.kicad_pcb, Cerebro.sch]
2019-10-25 update samd21e
    [Cerebro.sch]
2019-10-25 add logo
    [Cerebro.kicad_pcb]
2019-10-25 update pcb
    [Cerebro.kicad_pcb]
2019-10-28 basic componets
    [Cerebro.sch]
